Vinset85/smartofono/hardware/anteprime/01-vetro-frontale.png

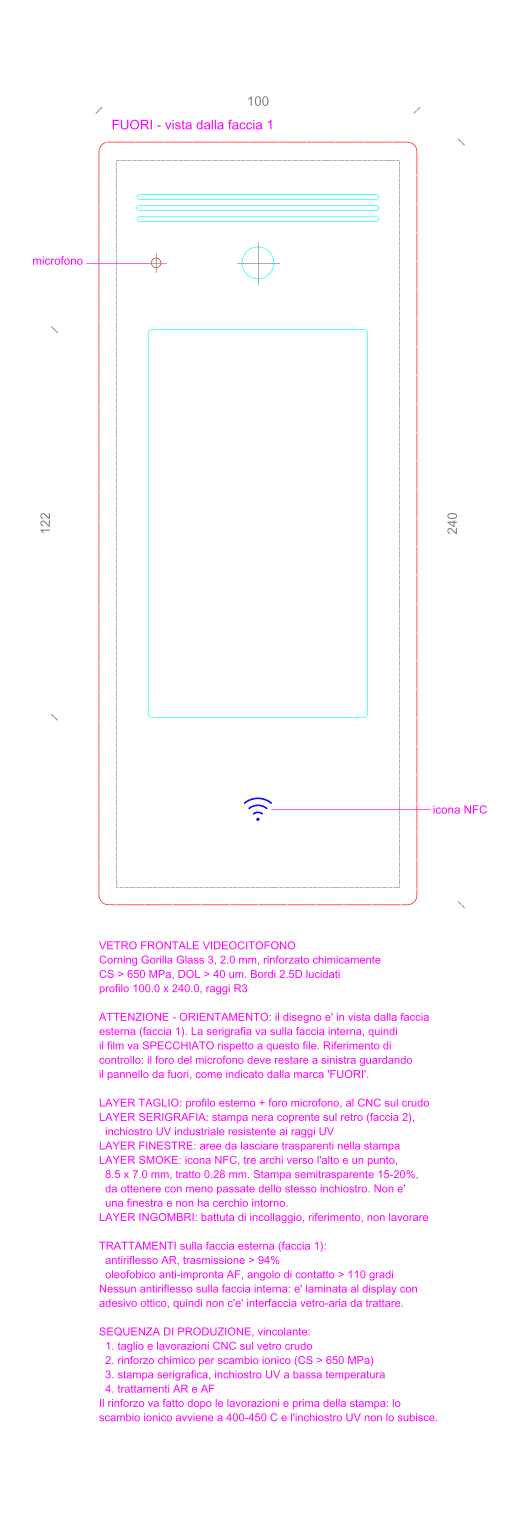
hardware/anteprime/01-vetro-frontale.png
