Vinset85/smartofono/hardware/anteprime/02-telaio-portante.png

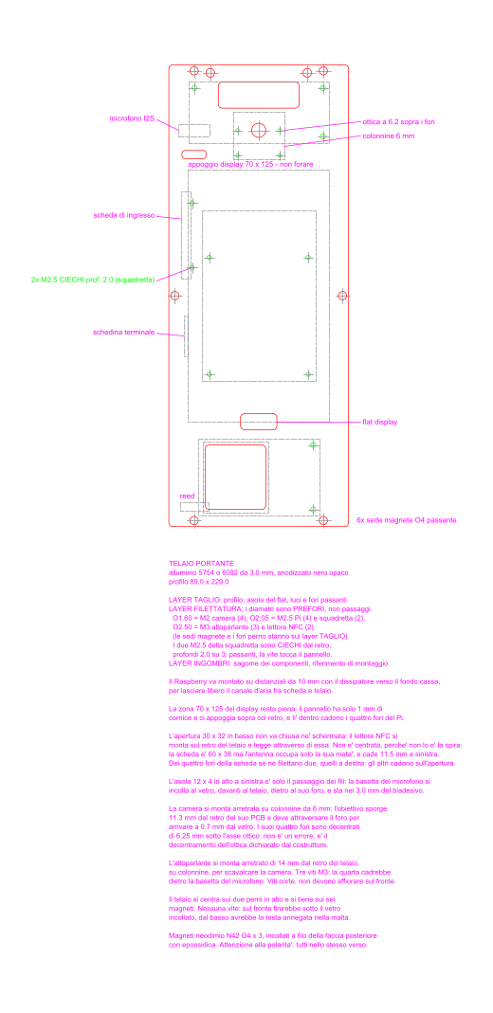
hardware/anteprime/02-telaio-portante.png
