Vinset85/smartofono/hardware/anteprime/03-cassa-incasso.png

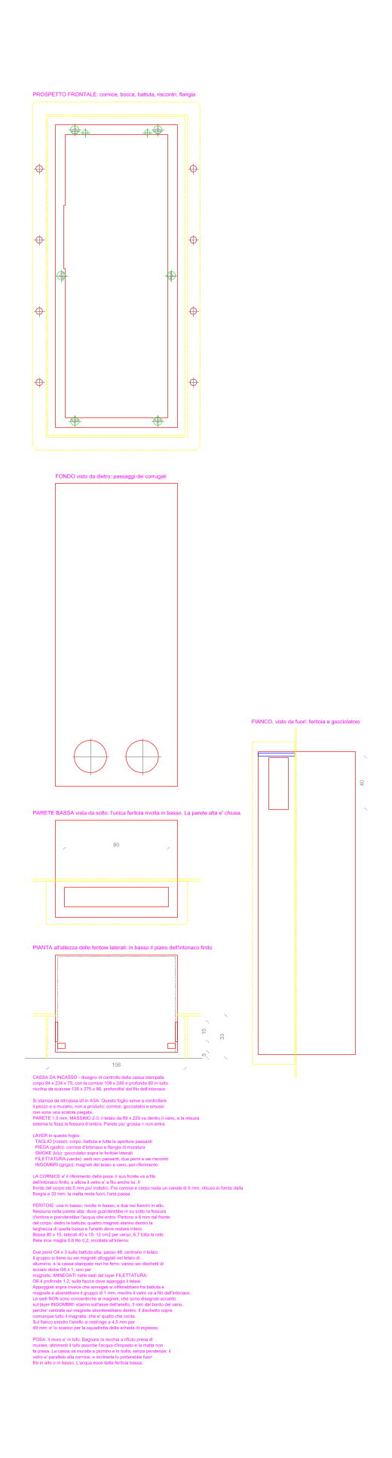
hardware/anteprime/03-cassa-incasso.png
