Vinset85/smartofono/hardware/anteprime/3d-assieme.png

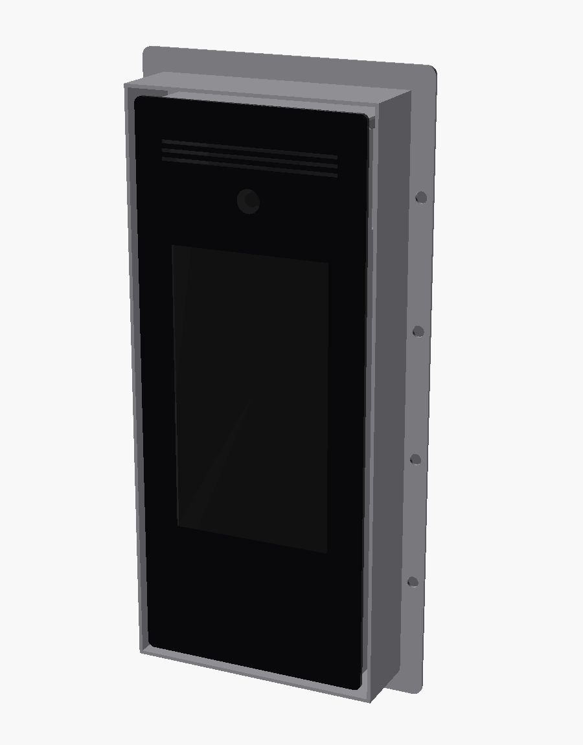
hardware/anteprime/3d-assieme.png
