Vinset85/smartofono/hardware/anteprime/3d-esploso.png

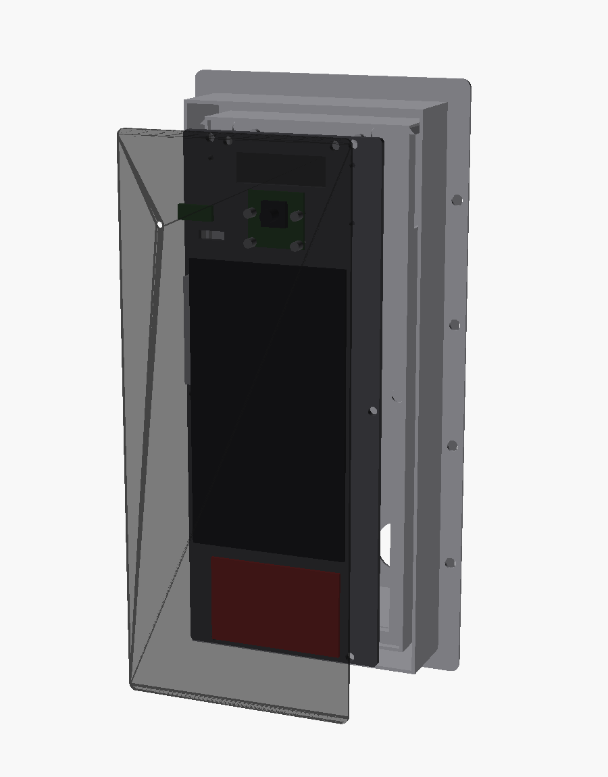
hardware/anteprime/3d-esploso.png
