Vinset85/smartofono/hardware/anteprime/3d-fronte.png

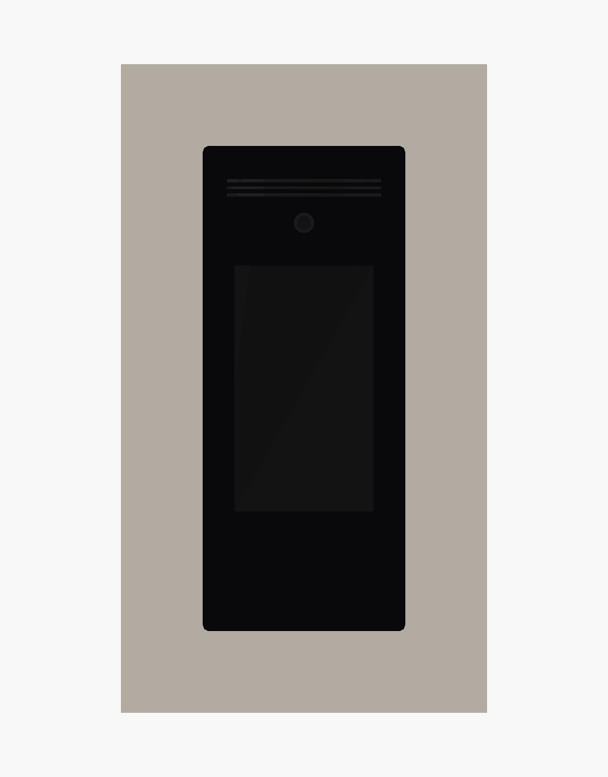
hardware/anteprime/3d-fronte.png
