Vinset85/smartofono/hardware/anteprime/3d-retro.png

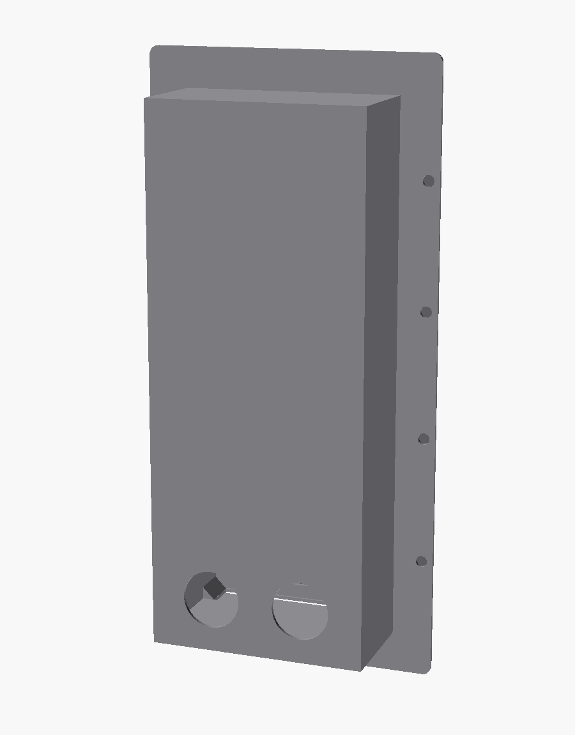
hardware/anteprime/3d-retro.png
