Vinset85/smartofono/hardware/anteprime/3d-sezione.png

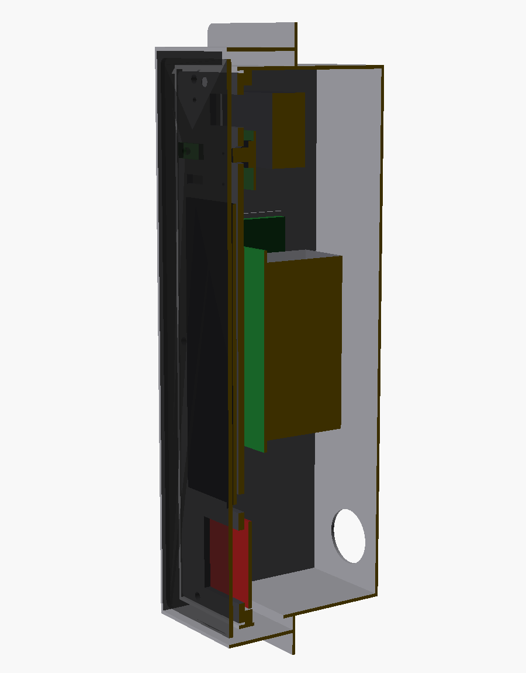
hardware/anteprime/3d-sezione.png
