Vinset85/smartofono/hardware/anteprime/04-dima-muratura.png

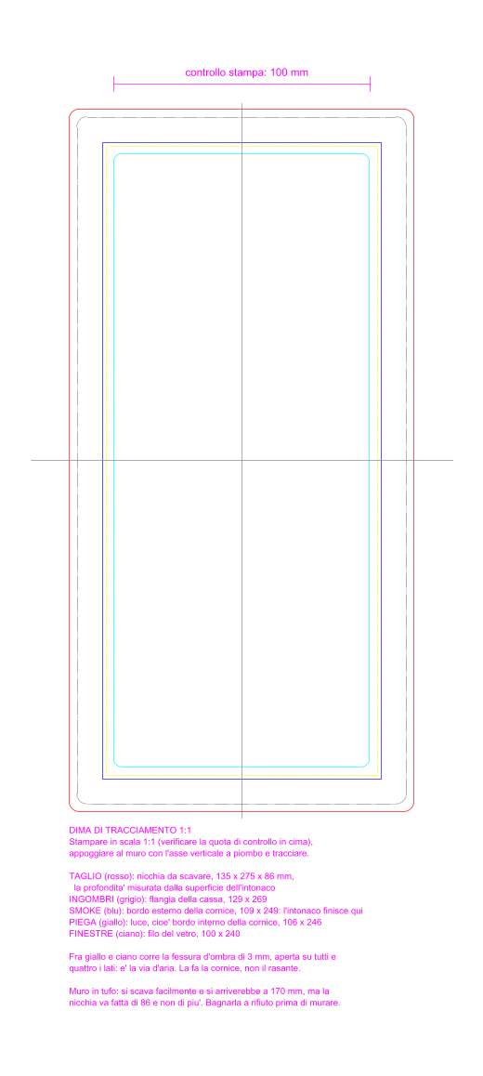
hardware/anteprime/04-dima-muratura.png
