Vinset85/smartofono/hardware/anteprime/05-disposizione.png

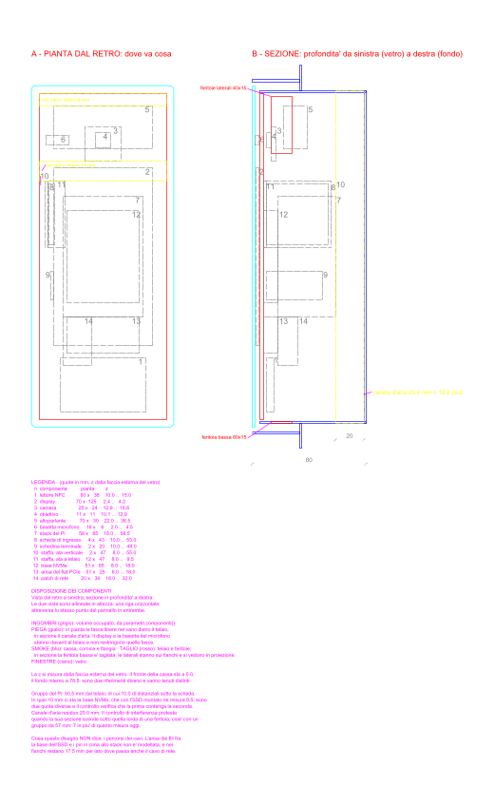
hardware/anteprime/05-disposizione.png
