Vinset85/smartofono/hardware/anteprime/06-gruppo-display.png

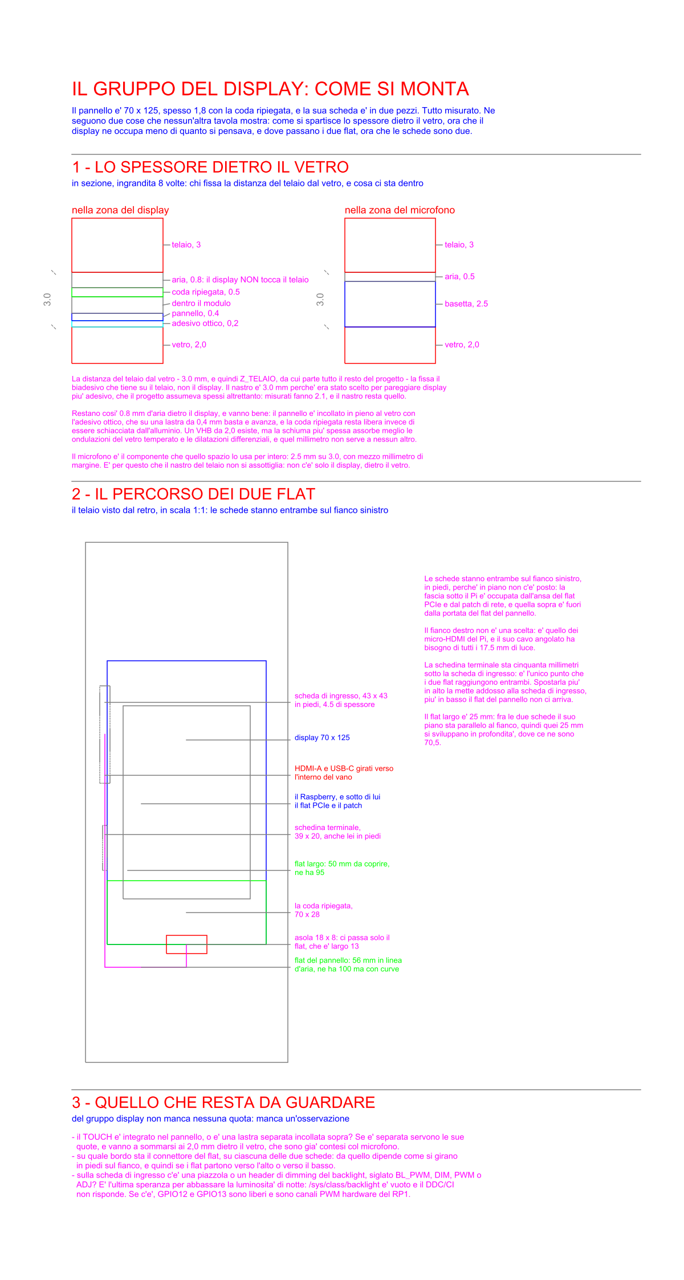
hardware/anteprime/06-gruppo-display.png
