Vinset85/smartofono/hardware/anteprime/07-staffa-e-pezzi-piani.png

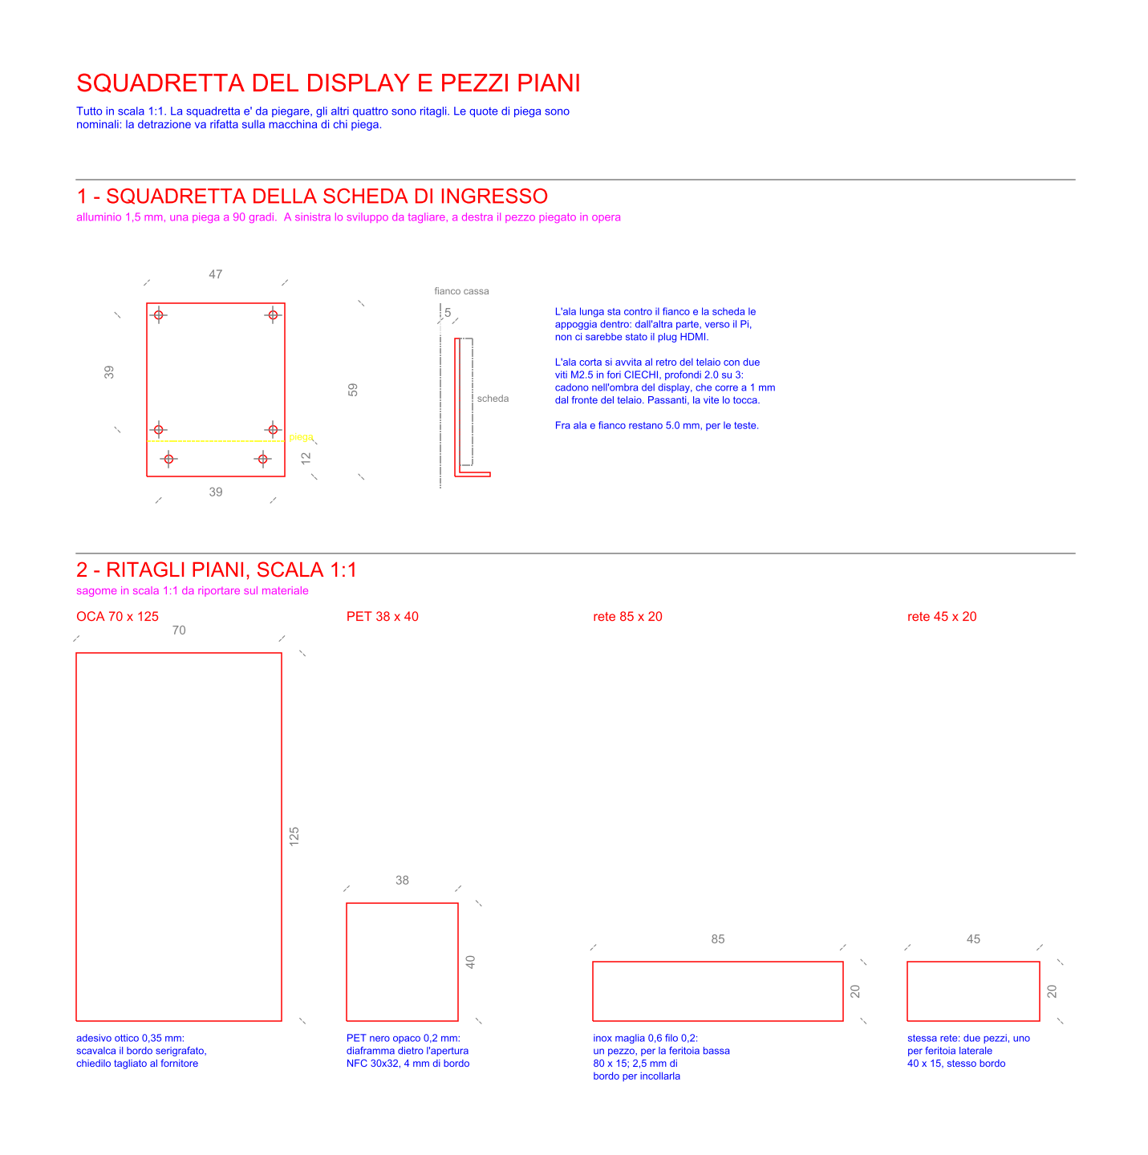
hardware/anteprime/07-staffa-e-pezzi-piani.png
