Vinset85/smartofono/hardware/render/inst-1-nicchia.jpg

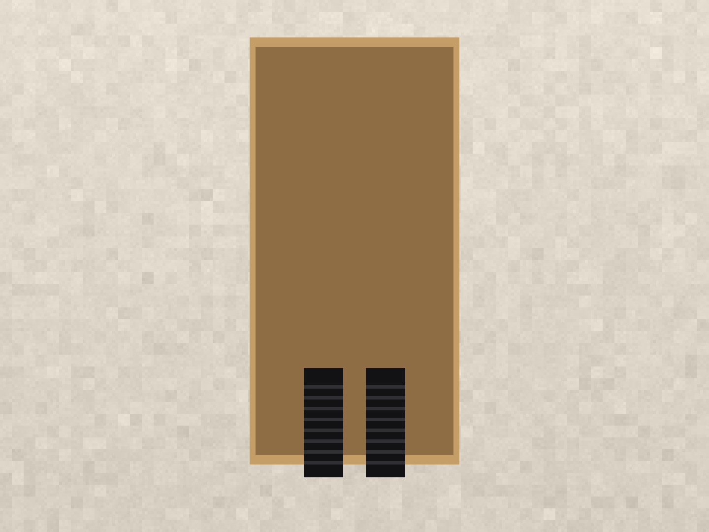
hardware/render/inst-1-nicchia.jpg
