Vinset85/smartofono/hardware/render/inst-2-cassa.jpg

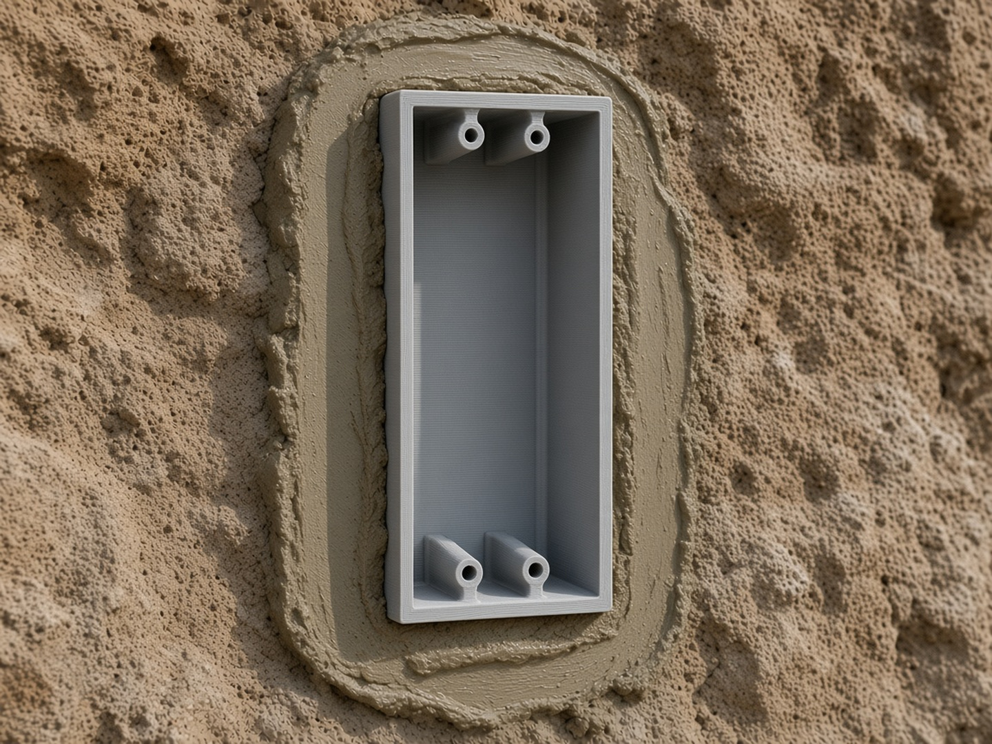
hardware/render/inst-2-cassa.jpg
