Vinset85/smartofono/hardware/render/inst-3-telaio.jpg

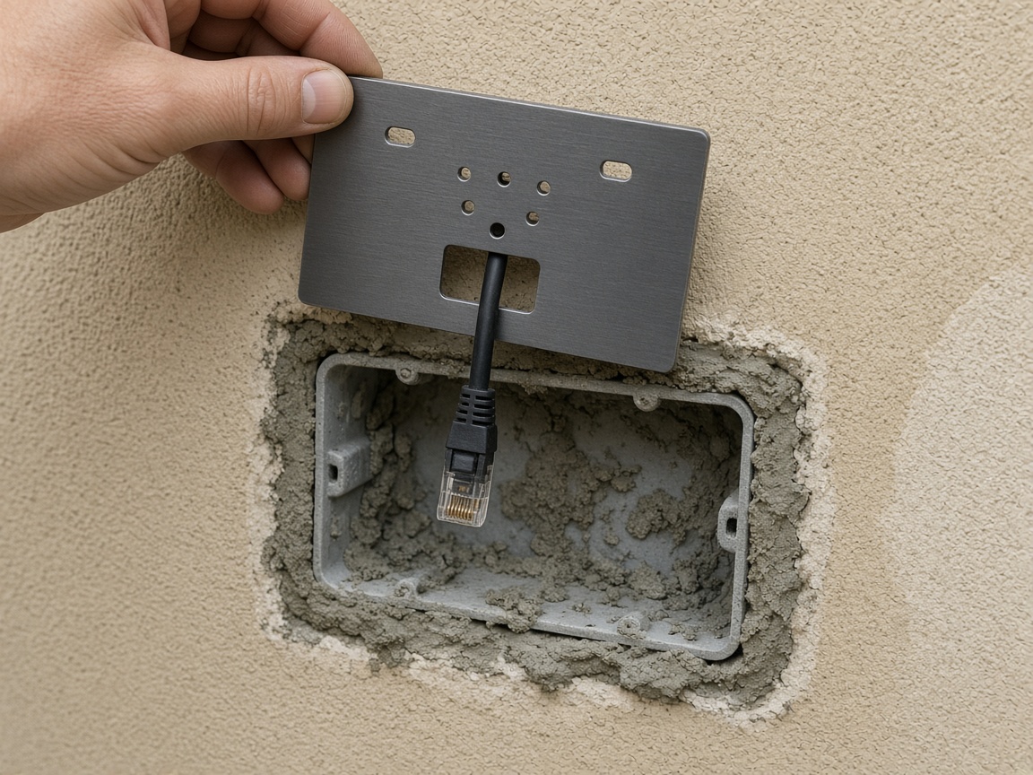
hardware/render/inst-3-telaio.jpg
