Vinset85/smartofono/hardware/render/inst-4-vetro.jpg

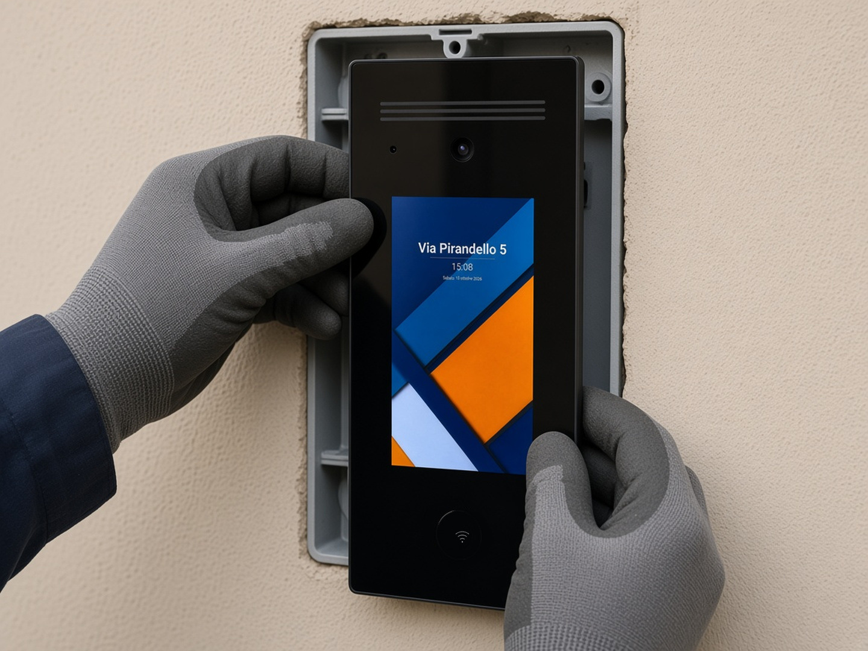
hardware/render/inst-4-vetro.jpg
