Vinset85/smartofono/hardware/render/materiali/alluminio-anodizzato.jpg

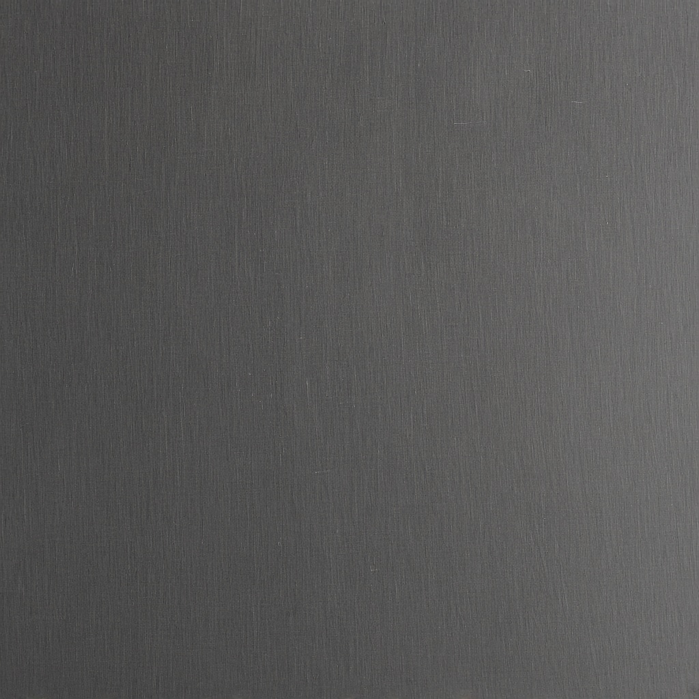
hardware/render/materiali/alluminio-anodizzato.jpg
