Vinset85/smartofono/hardware/render/materiali/angolo-muro.jpg

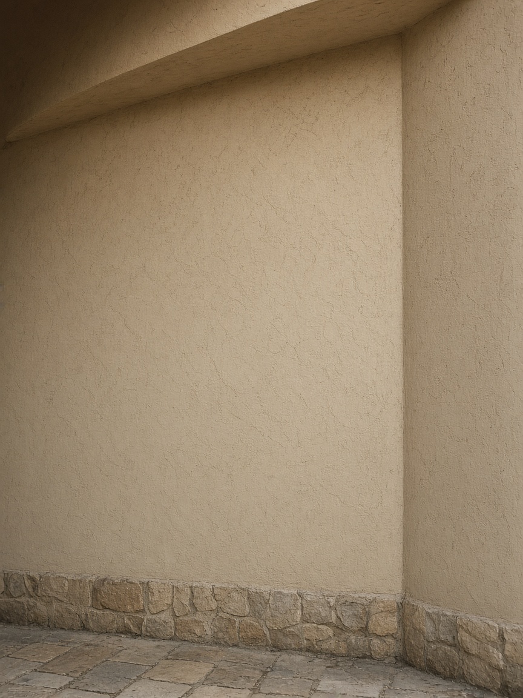
hardware/render/materiali/angolo-muro.jpg
