Vinset85/smartofono/hardware/render/materiali/asa-stampato.jpg

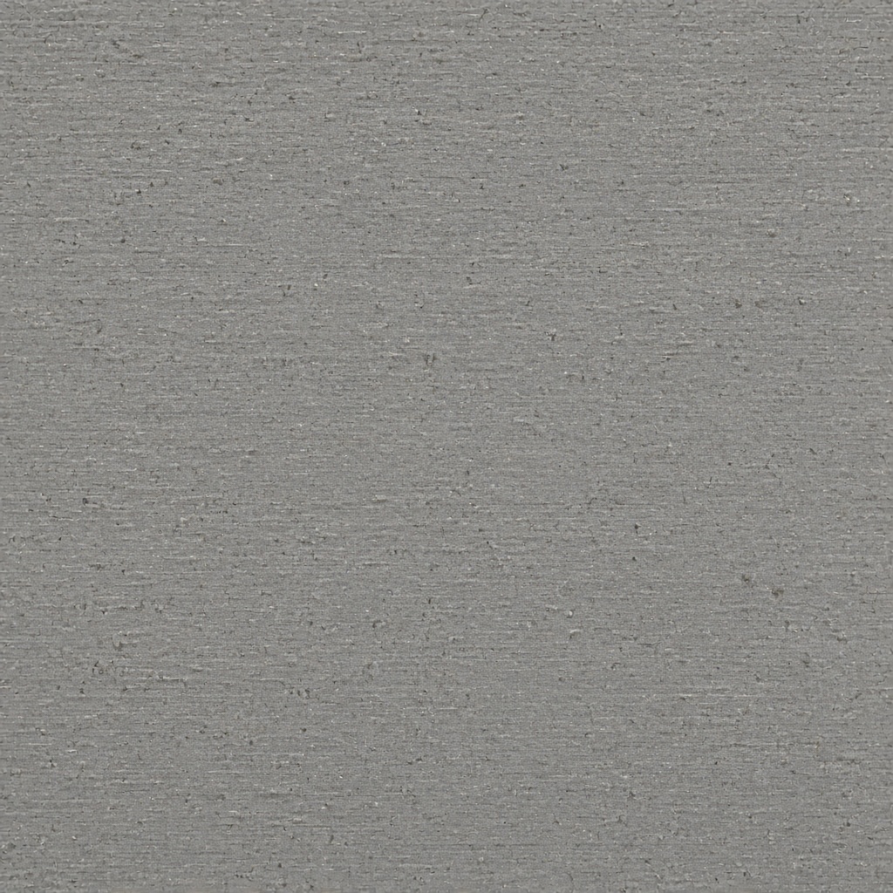
hardware/render/materiali/asa-stampato.jpg
