Vinset85/smartofono/hardware/render/materiali/dito-nero.jpg

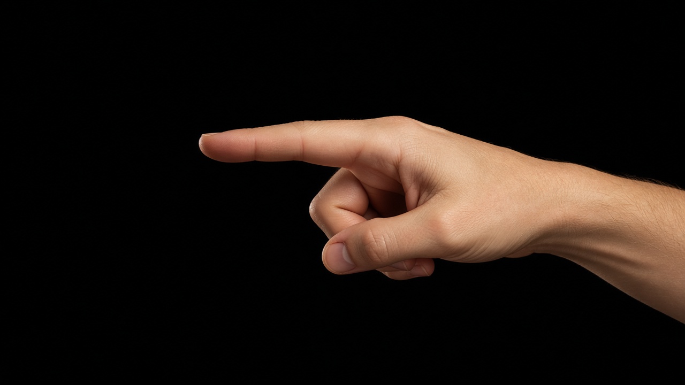
hardware/render/materiali/dito-nero.jpg
