Vinset85/smartofono/hardware/render/materiali/dito-vetro.jpg

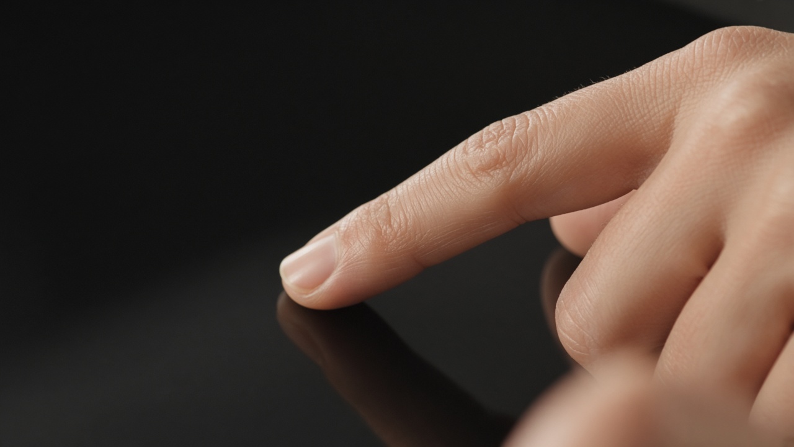
hardware/render/materiali/dito-vetro.jpg
