Vinset85/smartofono/hardware/render/materiali/intonaco-portico.jpg

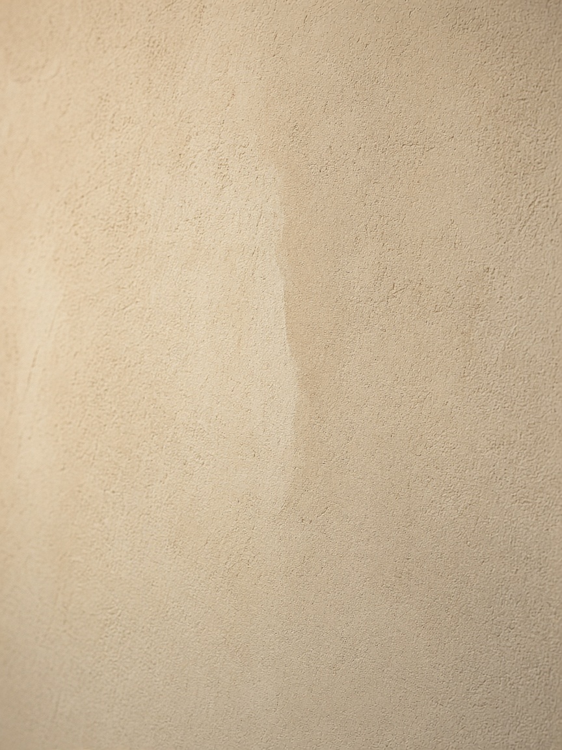
hardware/render/materiali/intonaco-portico.jpg
