Vinset85/smartofono/hardware/render/materiali/malta-fresca.jpg

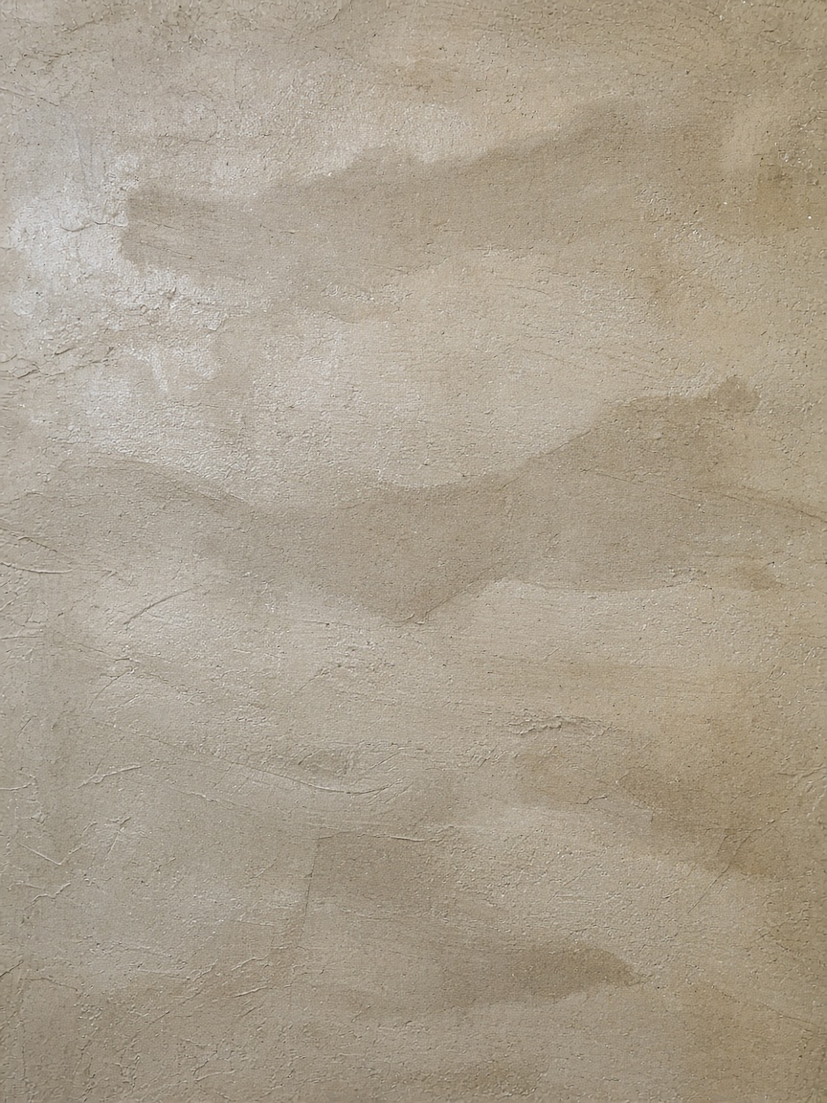
hardware/render/materiali/malta-fresca.jpg
