Vinset85/smartofono/hardware/render/materiali/oled-chiamata.jpg

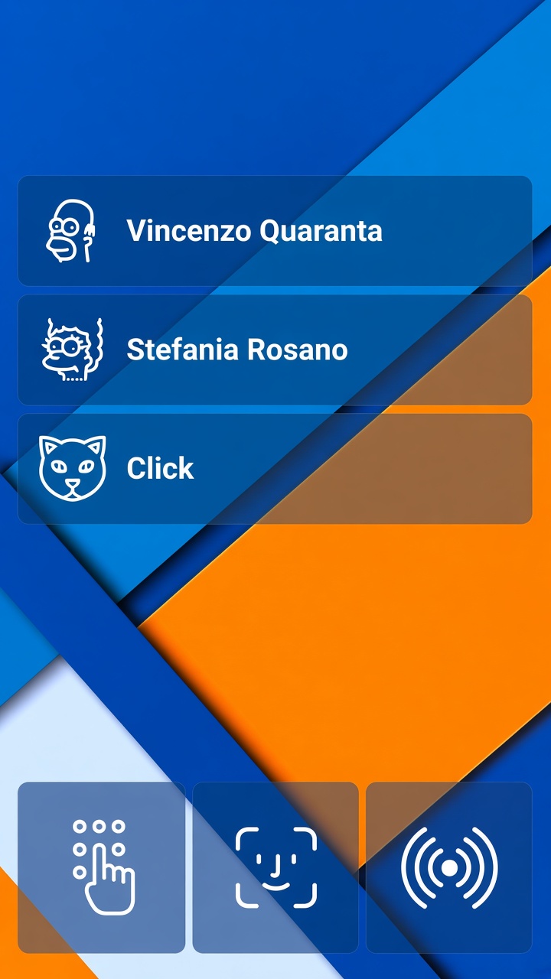
hardware/render/materiali/oled-chiamata.jpg
