Vinset85/smartofono/hardware/render/materiali/oled-riposo.jpg

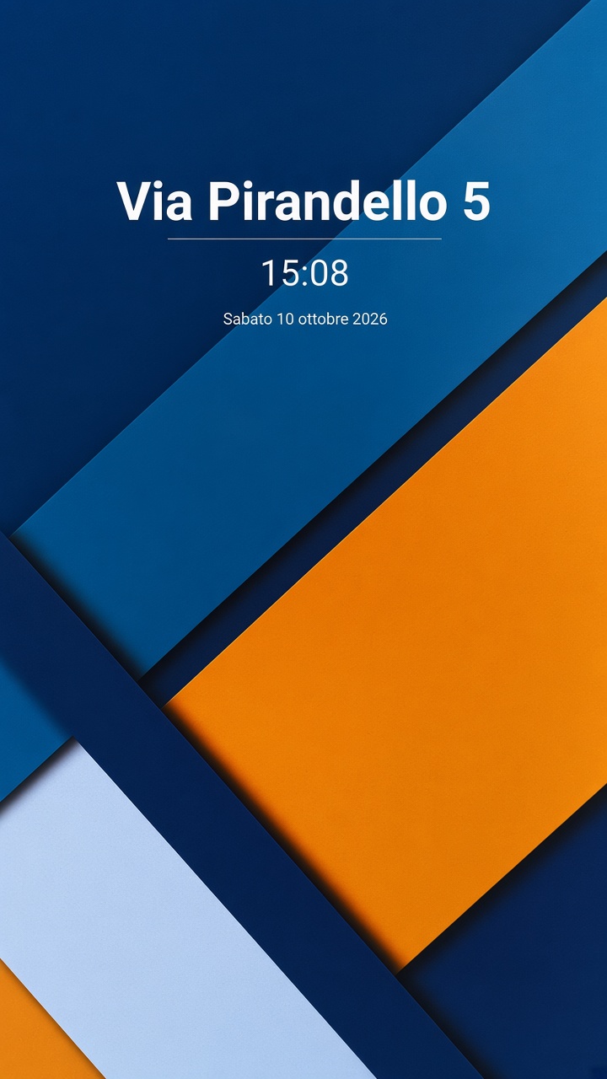
hardware/render/materiali/oled-riposo.jpg
