Vinset85/smartofono/hardware/render/materiali/porta-legno.jpg

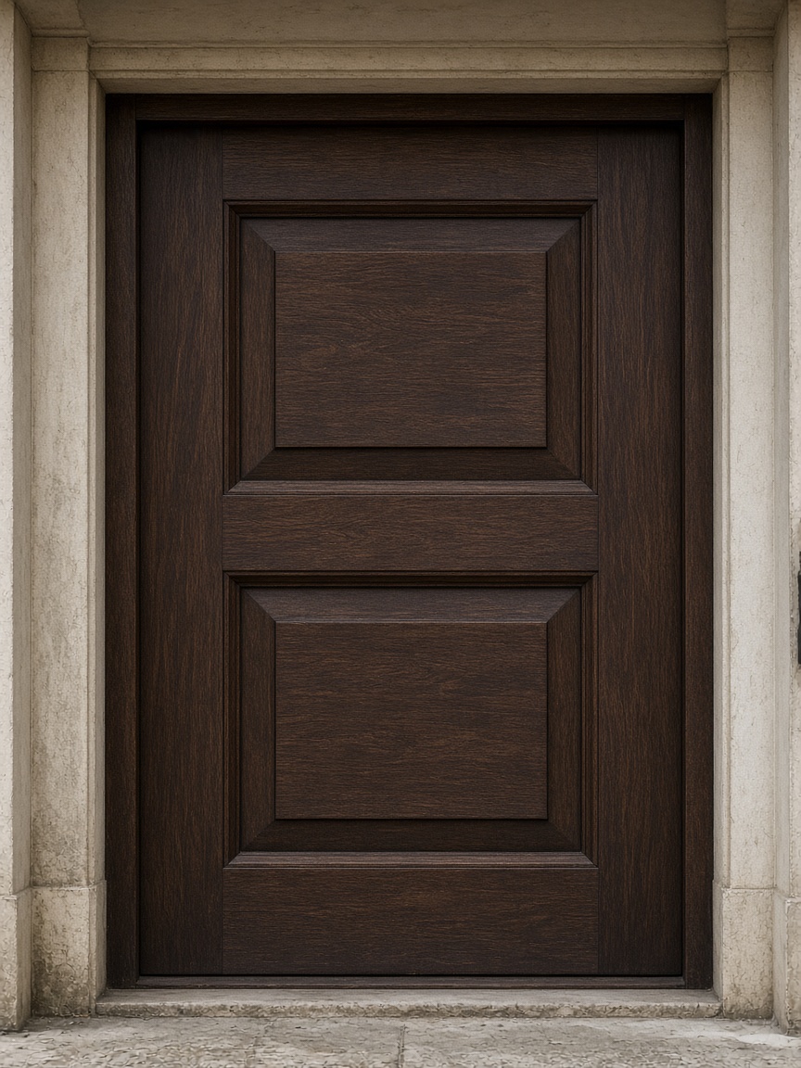
hardware/render/materiali/porta-legno.jpg
