Vinset85/smartofono/hardware/render/materiali/riflesso-portico.jpg

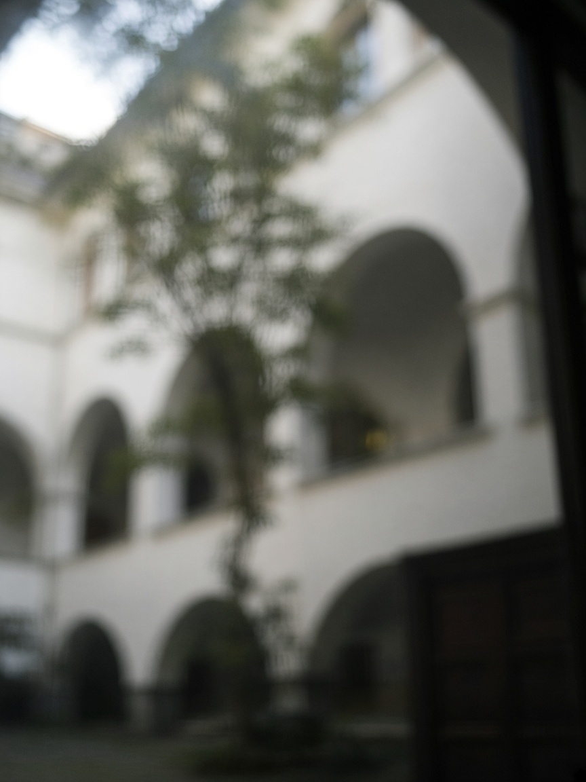
hardware/render/materiali/riflesso-portico.jpg
