Vinset85/smartofono/hardware/render/materiali/tufo-taglio.jpg

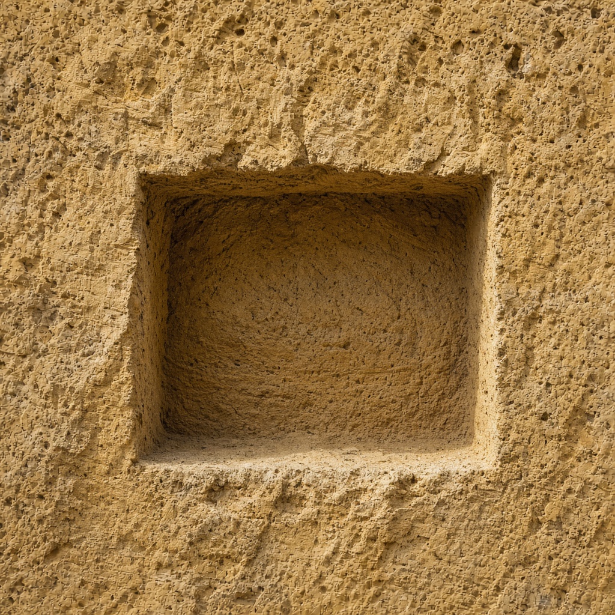
hardware/render/materiali/tufo-taglio.jpg
