Vinset85/smartofono/hardware/render/materiali/volto-nero.jpg

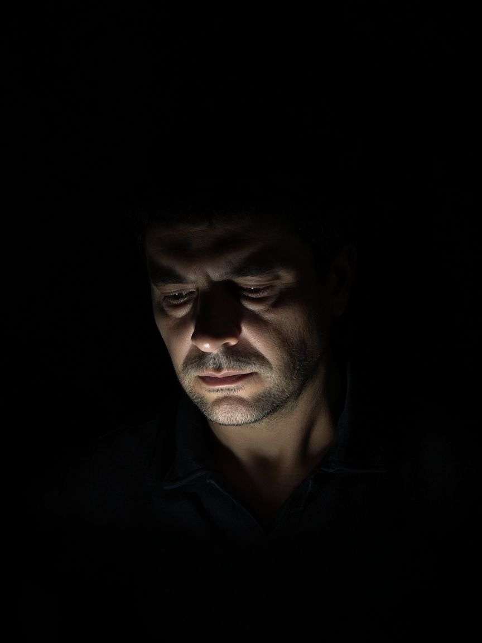
hardware/render/materiali/volto-nero.jpg
