Vinset85/smartofono/hardware/render/materiali/volto-sotto.jpg

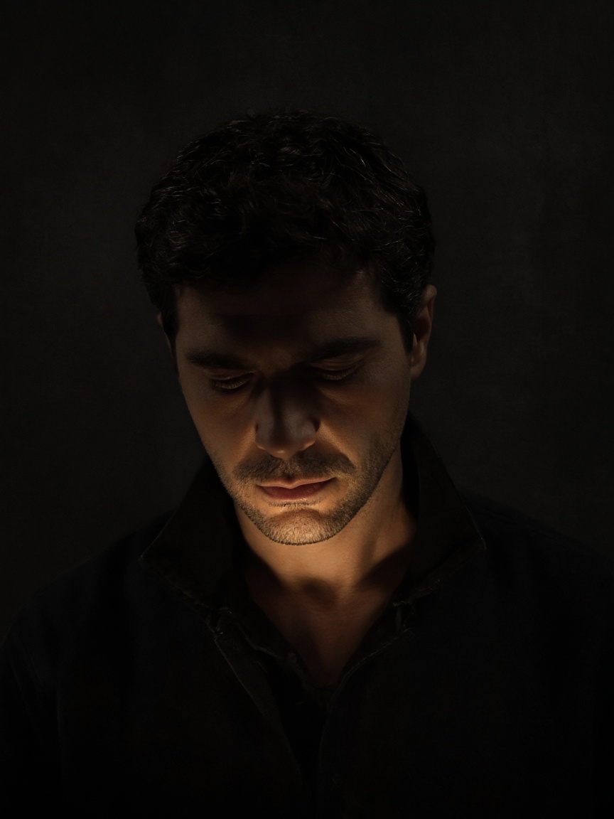
hardware/render/materiali/volto-sotto.jpg
