Vinset85/smartofono/hardware/render/scala/fronte-a-muro.jpg

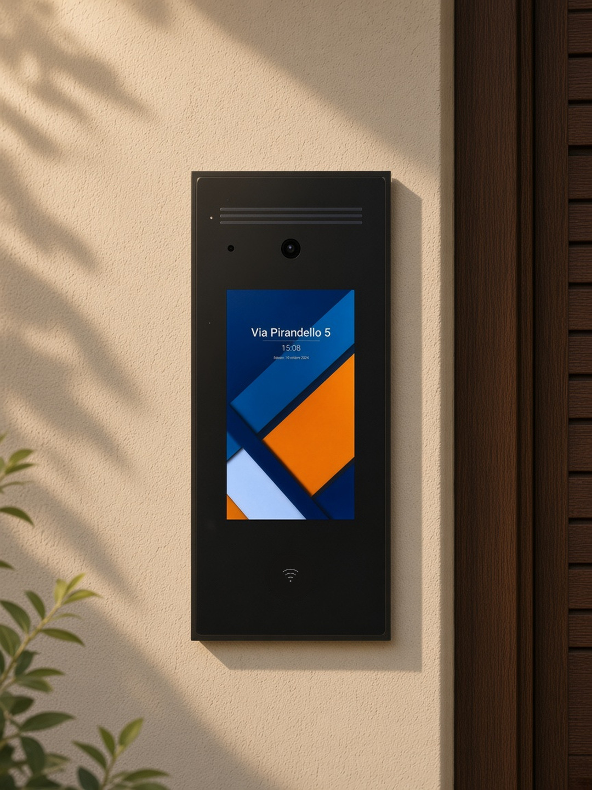
hardware/render/scala/fronte-a-muro.jpg
