Vinset85/smartofono/hardware/render/scala/func-1-giorno-riposo.jpg

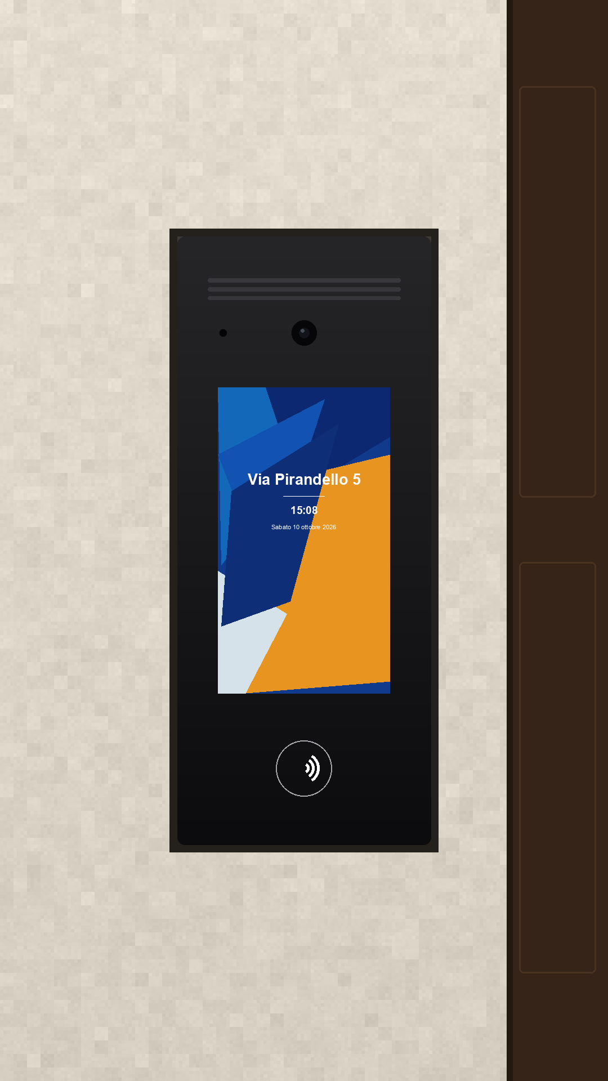
hardware/render/scala/func-1-giorno-riposo.jpg
