Vinset85/smartofono/hardware/render/scala/func-3-notte-piena.jpg

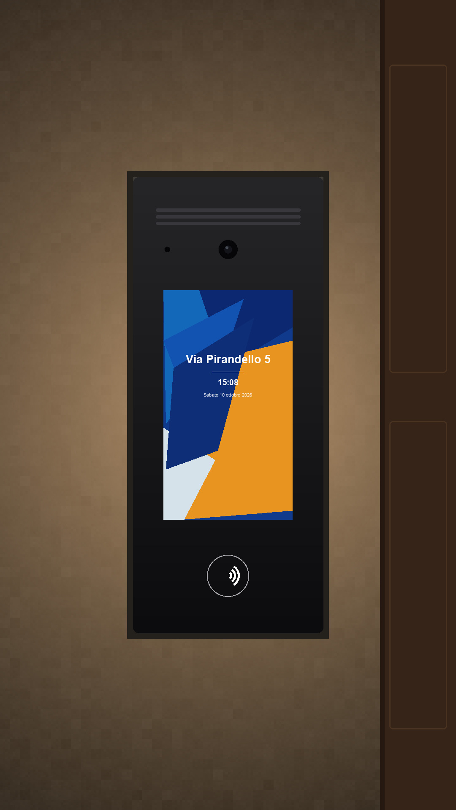
hardware/render/scala/func-3-notte-piena.jpg
