Vinset85/smartofono/hardware/render/scala/inst-2-cassa.jpg

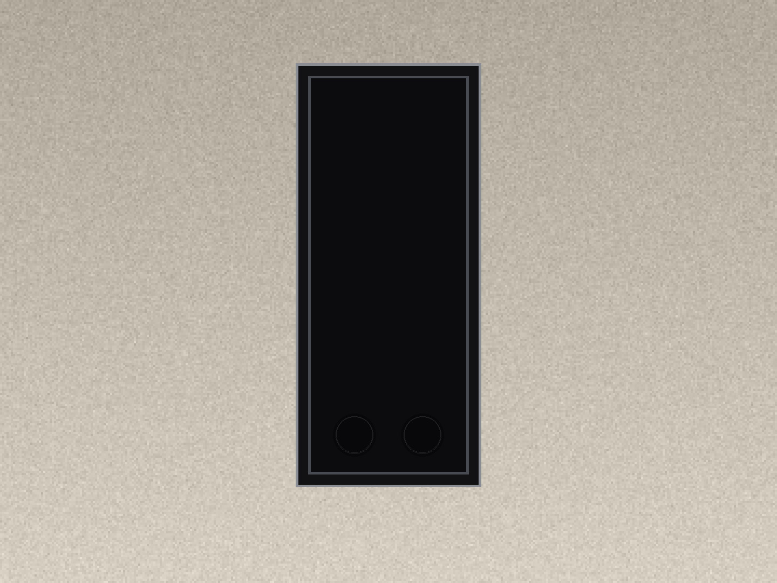
hardware/render/scala/inst-2-cassa.jpg
