Vinset85/smartofono/hardware/render/scala/inst-3-telaio.jpg

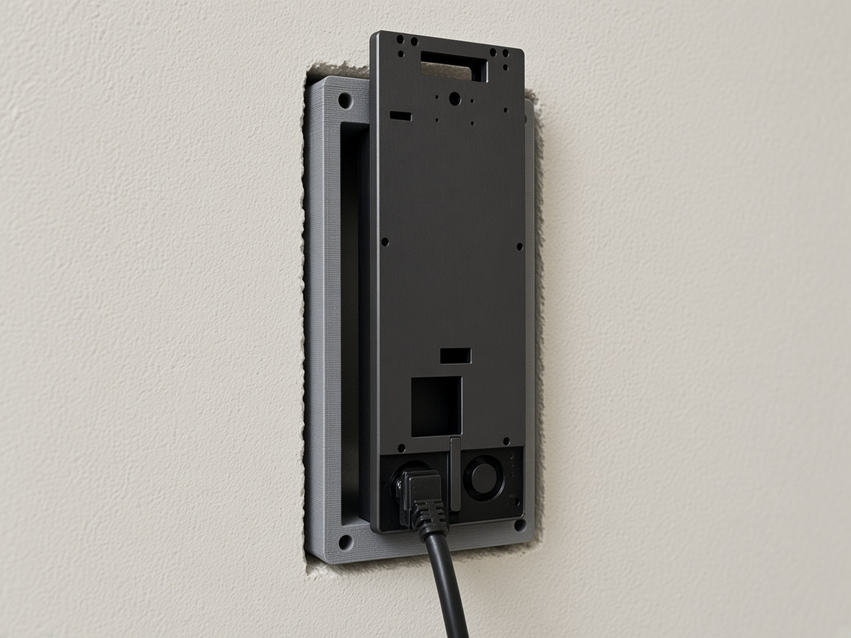
hardware/render/scala/inst-3-telaio.jpg
