Vinset85/smartofono/hardware/render/scala/inst-4-vetro.jpg

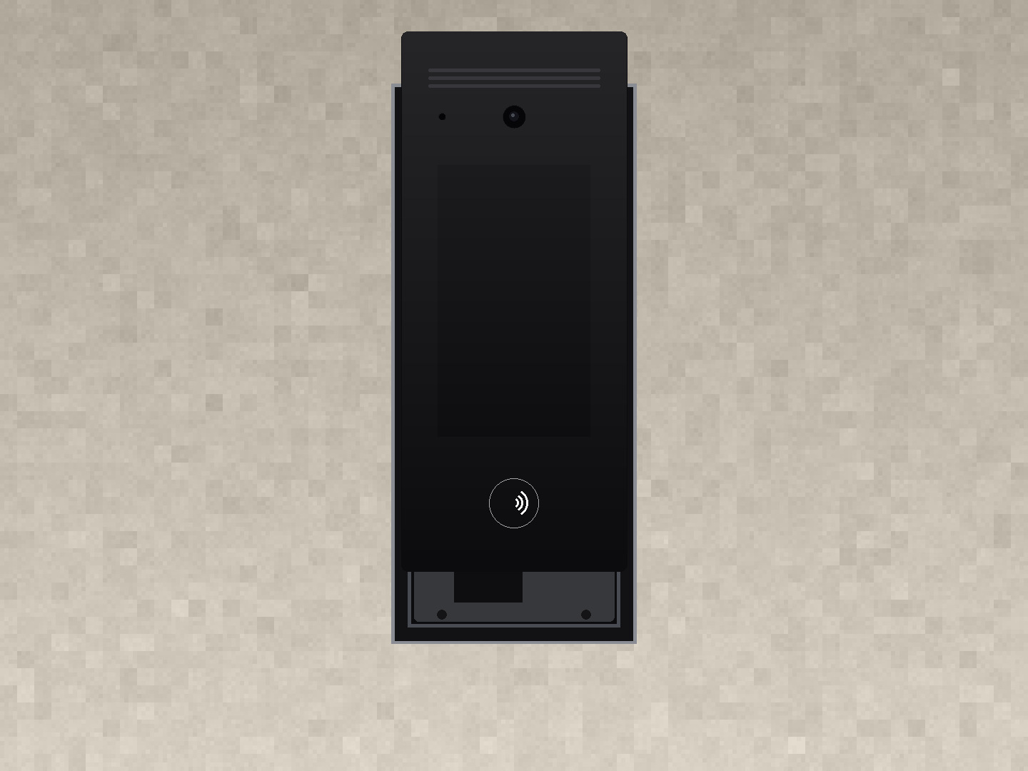
hardware/render/scala/inst-4-vetro.jpg
