Vinset85/smartofono/hardware/render/schermata-default.jpg

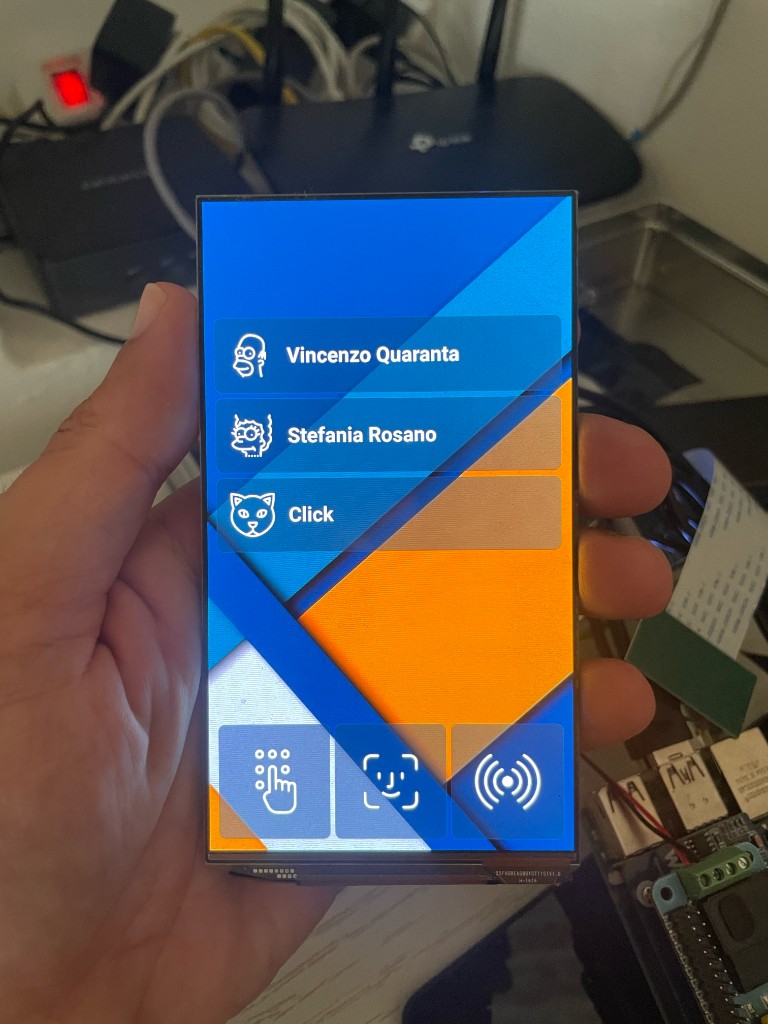
hardware/render/schermata-default.jpg
