Vinset85/smartofono/hardware/render/schermata-riposo.jpg

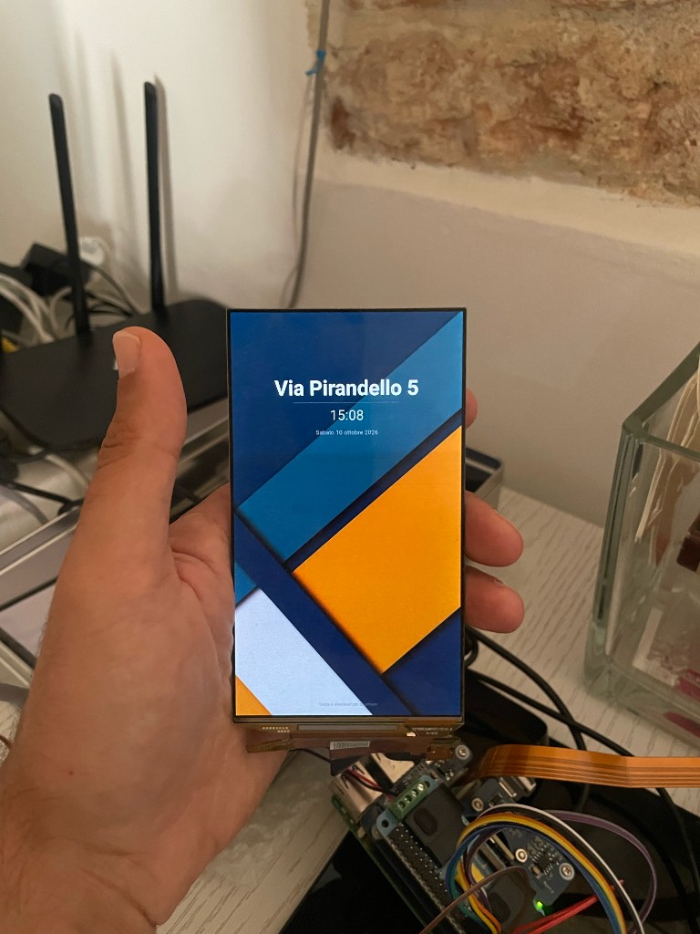
hardware/render/schermata-riposo.jpg
