Vinset85/smartofono/hardware/cad/05-disposizione.dxf

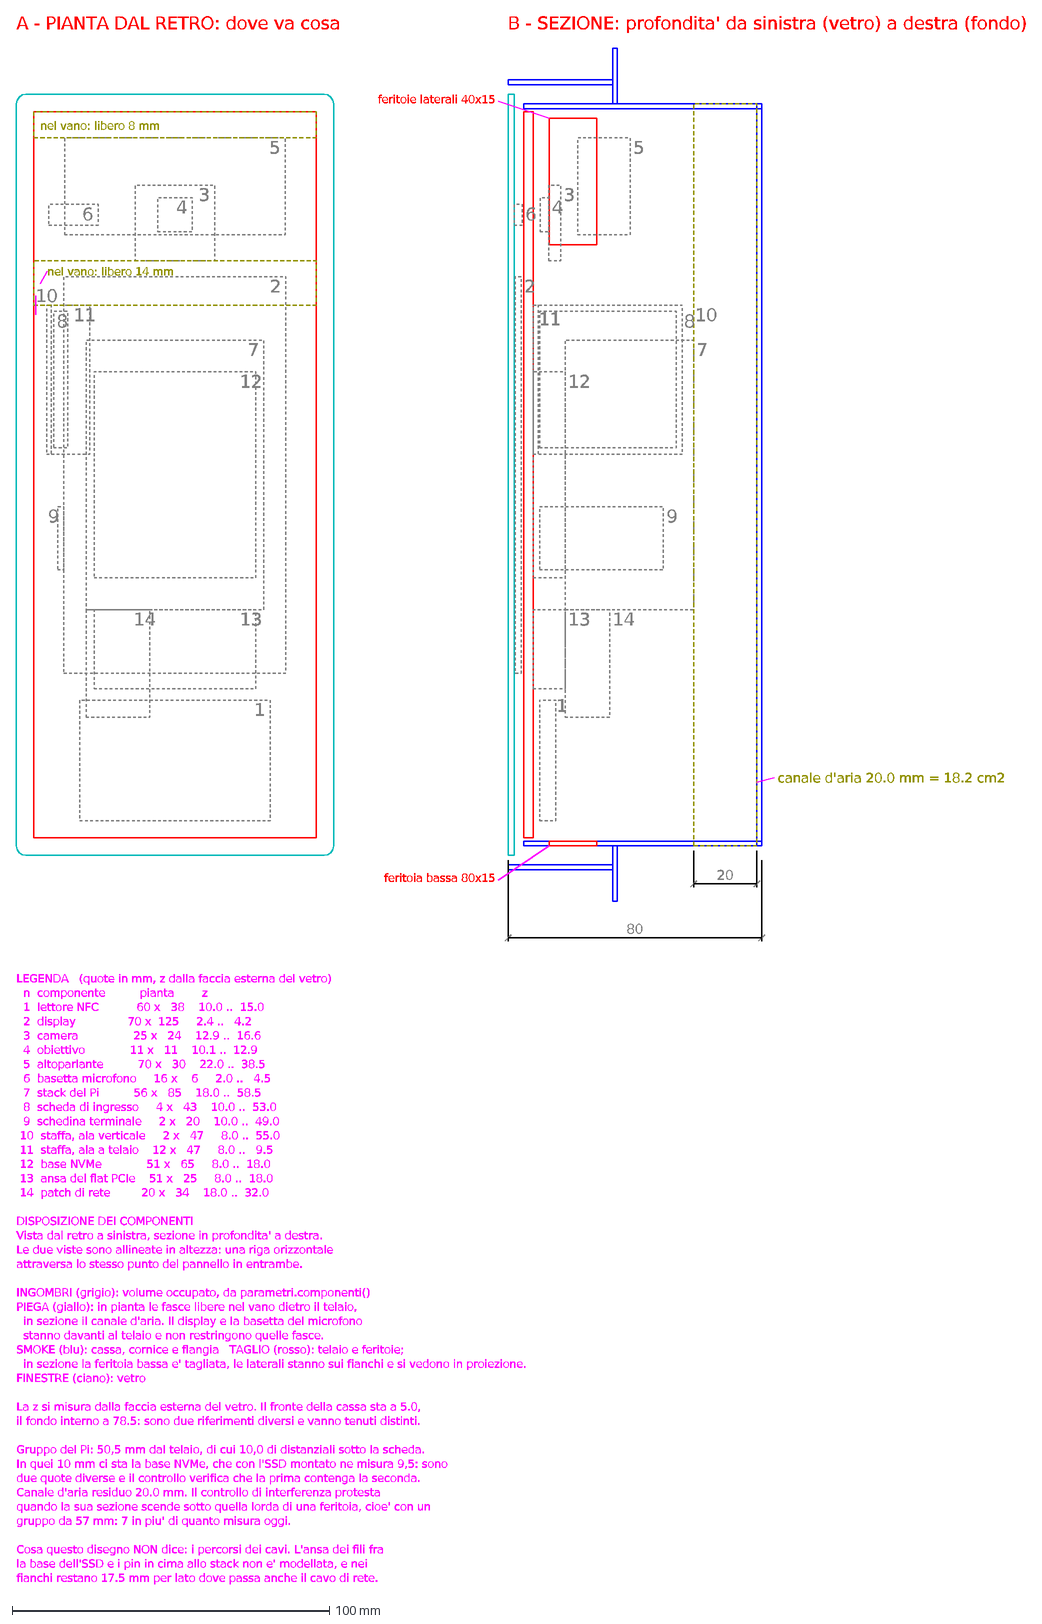
[picture p49: CAD file, 2026-10-16]
hardware/cad/05-disposizione.dxf
A - PIANTA DAL RETRO: dove va cosa
nel vano: libero 14 mm
nel vano: libero 8 mm
1
2
3
4
5
6
7
8
9
10
11
12
13
14
B - SEZIONE: profondita' da sinistra (vetro) a destra (fondo)
20
80
feritoia bassa 80x15
feritoie laterali 40x15
canale d'aria 20.0 mm = 18.2 cm2
LEGENDA (quote in mm, z dalla faccia esterna del vetro)
n componente pianta z
1 lettore NFC 60 x 38 10.0 .. 15.0
2 display 70 x 125 2.4 .. 4.2
3 camera 25 x 24 12.9 .. 16.6
4 obiettivo 11 x 11 10.1 .. 12.9
5 altoparlante 70 x 30 22.0 .. 38.5
6 basetta microfono 16 x 6 2.0 .. 4.5
7 stack del Pi 56 x 85 18.0 .. 58.5
8 scheda di ingresso 4 x 43 10.0 .. 53.0
9 schedina terminale 2 x 20 10.0 .. 49.0
10 staffa, ala verticale 2 x 47 8.0 .. 55.0
11 staffa, ala a telaio 12 x 47 8.0 .. 9.5
12 base NVMe 51 x 65 8.0 .. 18.0
13 ansa del flat PCIe 51 x 25 8.0 .. 18.0
14 patch di rete 20 x 34 18.0 .. 32.0
DISPOSIZIONE DEI COMPONENTI
Vista dal retro a sinistra, sezione in profondita' a destra.
Le due viste sono allineate in altezza: una riga orizzontale
attraversa lo stesso punto del pannello in entrambe.
INGOMBRI (grigio): volume occupato, da parametri.componenti()
PIEGA (giallo): in pianta le fasce libere nel vano dietro il telaio,
in sezione il canale d'aria. Il display e la basetta del microfono
stanno davanti al telaio e non restringono quelle fasce.
SMOKE (blu): cassa, cornice e flangia TAGLIO (rosso): telaio e feritoie;
in sezione la feritoia bassa e' tagliata, le laterali stanno sui fianchi e si vedono in proiezione.
FINESTRE (ciano): vetro
La z si misura dalla faccia esterna del vetro. Il fronte della cassa sta a 5.0,
il fondo interno a 78.5: sono due riferimenti diversi e vanno tenuti distinti.
Gruppo del Pi: 50,5 mm dal telaio, di cui 10,0 di distanziali sotto la scheda.
In quei 10 mm ci sta la base NVMe, che con l'SSD montato ne misura 9,5: sono
due quote diverse e il controllo verifica che la prima contenga la seconda.
Canale d'aria residuo 20.0 mm. Il controllo di interferenza protesta
quando la sua sezione scende sotto quella lorda di una feritoia, cioe' con un
gruppo da 57 mm: 7 in piu' di quanto misura oggi.
Cosa questo disegno NON dice: i percorsi dei cavi. L'ansa dei fili fra
la base dell'SSD e i pin in cima allo stack non e' modellata, e nei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
