Vinset85/smartofono/hardware/stl/cassa.stl

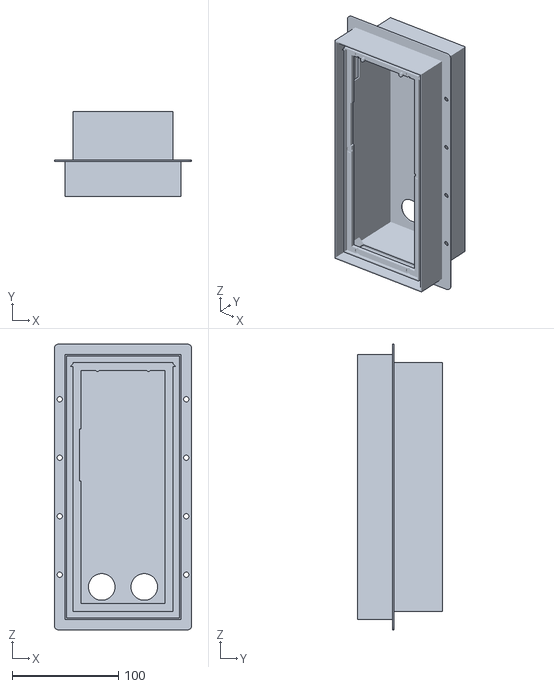
[picture p50: CAD file, 2026-10-11]
hardware/stl/cassa.stl
129.0 x 80.0 x 269.0
