Vinset85/smartofono/hardware/cad/07-staffa-e-pezzi-piani.dxf

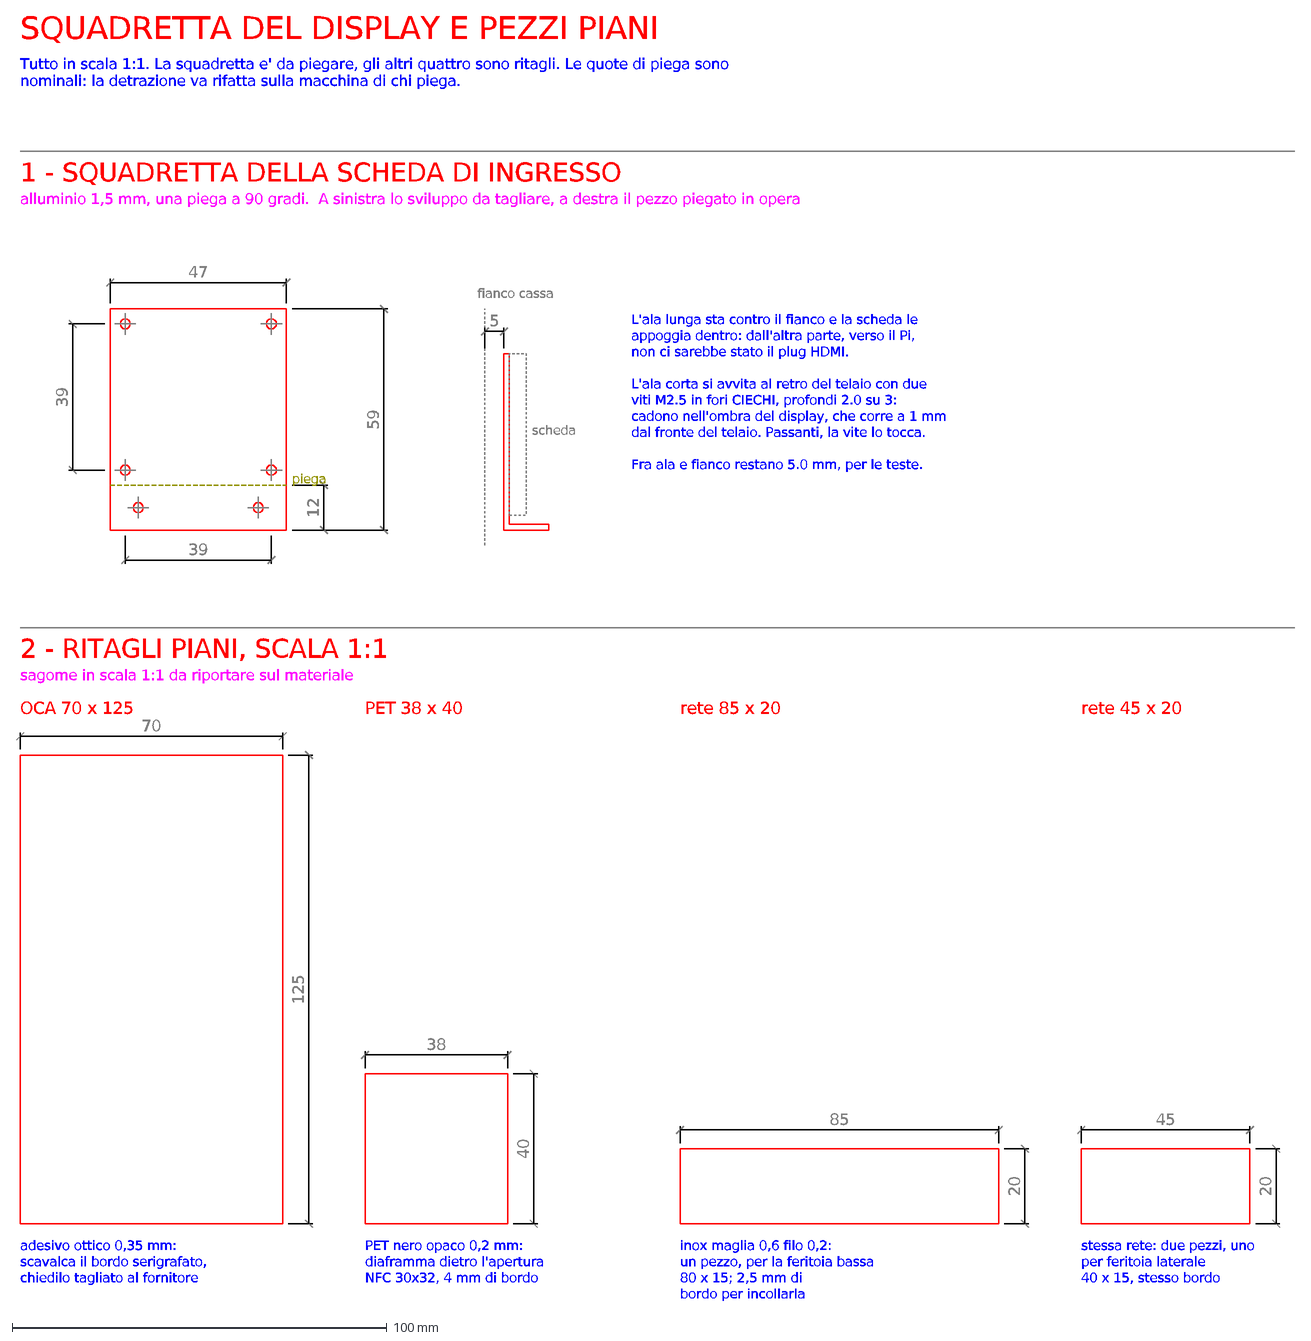
[picture p51: CAD file, 2026-10-16]
hardware/cad/07-staffa-e-pezzi-piani.dxf
SQUADRETTA DEL DISPLAY E PEZZI PIANI
Tutto in scala 1:1. La squadretta e' da piegare, gli altri quattro sono ritagli. Le quote di piega sono
nominali: la detrazione va rifatta sulla macchina di chi piega.
1 - SQUADRETTA DELLA SCHEDA DI INGRESSO
alluminio 1,5 mm, una piega a 90 gradi. A sinistra lo sviluppo da tagliare, a destra il pezzo piegato in opera
47
39
59
12
piega
scheda
fianco cassa
5
L'ala lunga sta contro il fianco e la scheda le
appoggia dentro: dall'altra parte, verso il Pi,
non ci sarebbe stato il plug HDMI.
L'ala corta si avvita al retro del telaio con due
viti M2.5 in fori CIECHI, profondi 2.0 su 3:
cadono nell'ombra del display, che corre a 1 mm
dal fronte del telaio. Passanti, la vite lo tocca.
Fra ala e fianco restano 5.0 mm, per le teste.
2 - RITAGLI PIANI, SCALA 1:1
sagome in scala 1:1 da riportare sul materiale
OCA 70 x 125
70
125
adesivo ottico 0,35 mm:
scavalca il bordo serigrafato,
chiedilo tagliato al fornitore
PET 38 x 40
38
40
PET nero opaco 0,2 mm:
diaframma dietro l'apertura
NFC 30x32, 4 mm di bordo
rete 85 x 20
85
20
inox maglia 0,6 filo 0,2:
un pezzo, per la feritoia bassa
80 x 15; 2,5 mm di
bordo per incollarla
rete 45 x 20
45
stessa rete: due pezzi, uno
per feritoia laterale
40 x 15, stesso bordo
