Vinset85/smartofono/hardware/stl/vetro.stl

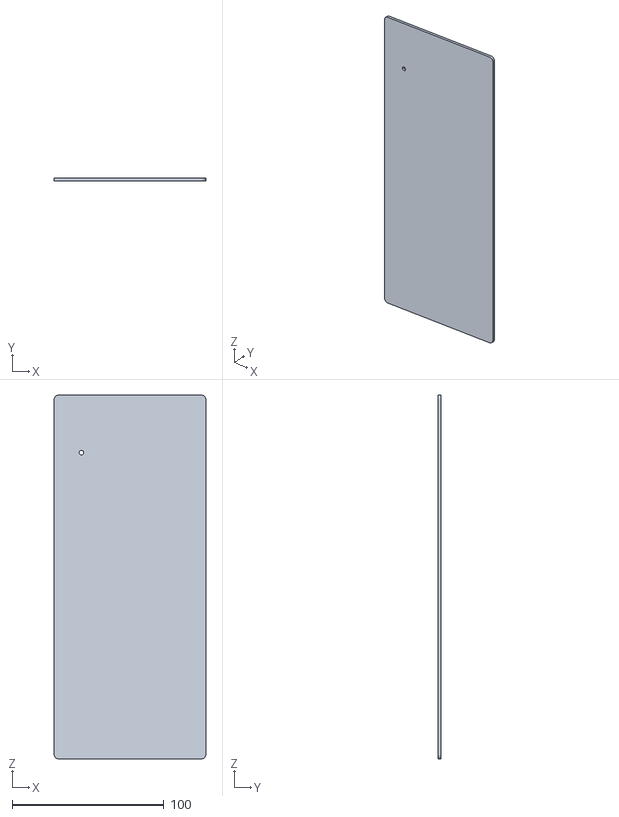
[picture p52: CAD file, 2026-10-10]
hardware/stl/vetro.stl
100.0 x 2.00 x 240.0
