Vinset85/smartofono/hardware/cad/06-gruppo-display.dxf

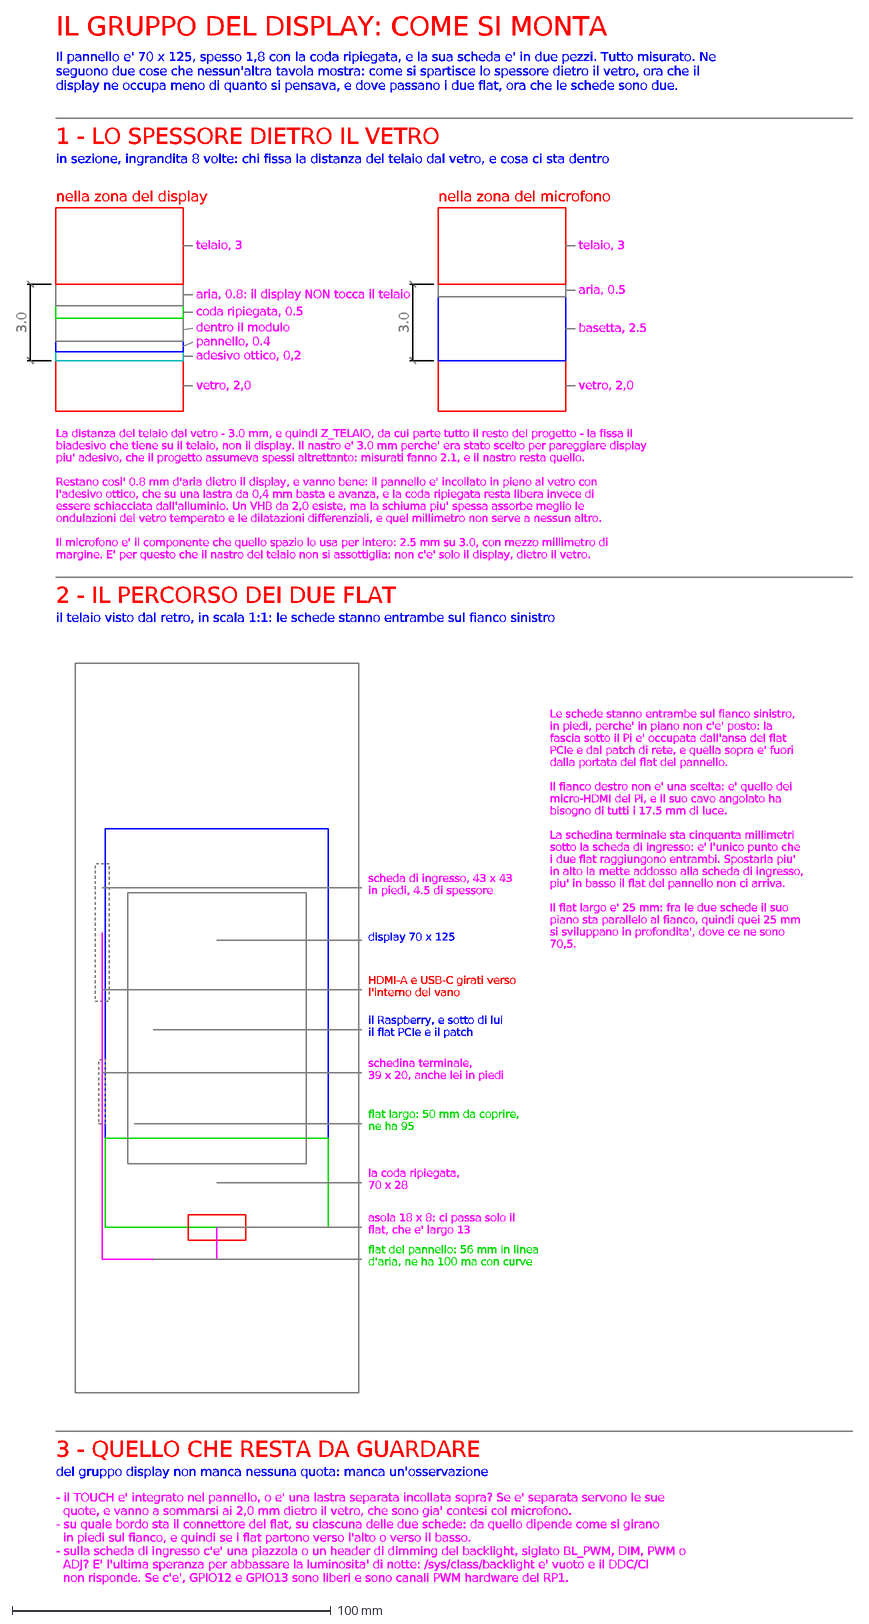
[picture p53: CAD file, 2026-10-16]
hardware/cad/06-gruppo-display.dxf
IL GRUPPO DEL DISPLAY: COME SI MONTA
Il pannello e' 70 x 125, spesso 1,8 con la coda ripiegata, e la sua scheda e' in due pezzi. Tutto misurato. Ne
seguono due cose che nessun'altra tavola mostra: come si spartisce lo spessore dietro il vetro, ora che il
display ne occupa meno di quanto si pensava, e dove passano i due flat, ora che le schede sono due.
1 - LO SPESSORE DIETRO IL VETRO
in sezione, ingrandita 8 volte: chi fissa la distanza del telaio dal vetro, e cosa ci sta dentro
nella zona del display
vetro, 2,0
adesivo ottico, 0,2
pannello, 0.4
dentro il modulo
coda ripiegata, 0.5
aria, 0.8: il display NON tocca il telaio
telaio, 3
3.0
nella zona del microfono
basetta, 2.5
aria, 0.5
La distanza del telaio dal vetro - 3.0 mm, e quindi Z_TELAIO, da cui parte tutto il resto del progetto - la fissa il
biadesivo che tiene su il telaio, non il display. Il nastro e' 3.0 mm perche' era stato scelto per pareggiare display
piu' adesivo, che il progetto assumeva spessi altrettanto: misurati fanno 2.1, e il nastro resta quello.
Restano cosi' 0.8 mm d'aria dietro il display, e vanno bene: il pannello e' incollato in pieno al vetro con
l'adesivo ottico, che su una lastra da 0,4 mm basta e avanza, e la coda ripiegata resta libera invece di
essere schiacciata dall'alluminio. Un VHB da 2,0 esiste, ma la schiuma piu' spessa assorbe meglio le
ondulazioni del vetro temperato e le dilatazioni differenziali, e quel millimetro non serve a nessun altro.
Il microfono e' il componente che quello spazio lo usa per intero: 2.5 mm su 3.0, con mezzo millimetro di
margine. E' per questo che il nastro del telaio non si assottiglia: non c'e' solo il display, dietro il vetro.
2 - IL PERCORSO DEI DUE FLAT
il telaio visto dal retro, in scala 1:1: le schede stanno entrambe sul fianco sinistro
scheda di ingresso, 43 x 43
in piedi, 4.5 di spessore
HDMI-A e USB-C girati verso
l'interno del vano
schedina terminale,
39 x 20, anche lei in piedi
flat largo: 50 mm da coprire,
ne ha 95
asola 18 x 8: ci passa solo il
flat, che e' largo 13
flat del pannello: 56 mm in linea
d'aria, ne ha 100 ma con curve
la coda ripiegata,
70 x 28
display 70 x 125
il Raspberry, e sotto di lui
il flat PCIe e il patch
Le schede stanno entrambe sul fianco sinistro,
in piedi, perche' in piano non c'e' posto: la
fascia sotto il Pi e' occupata dall'ansa del flat
PCIe e dal patch di rete, e quella sopra e' fuori
dalla portata del flat del pannello.
Il fianco destro non e' una scelta: e' quello dei
micro-HDMI del Pi, e il suo cavo angolato ha
bisogno di tutti i 17.5 mm di luce.
La schedina terminale sta cinquanta millimetri
sotto la scheda di ingresso: e' l'unico punto che
i due flat raggiungono entrambi. Spostarla piu'
in alto la mette addosso alla scheda di ingresso,
piu' in basso il flat del pannello non ci arriva.
Il flat largo e' 25 mm: fra le due schede il suo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
