Vinset85/smartofono/hardware/stl/telaio.stl

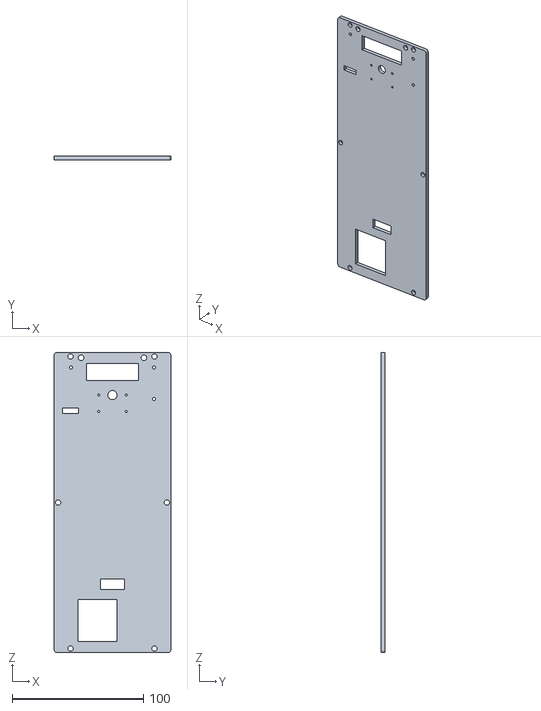
[picture p54: CAD file, 2026-10-10]
hardware/stl/telaio.stl
89.0 x 3.00 x 229.0
