Vinset85/smartofono/hardware/cad/02-telaio-portante.dxf

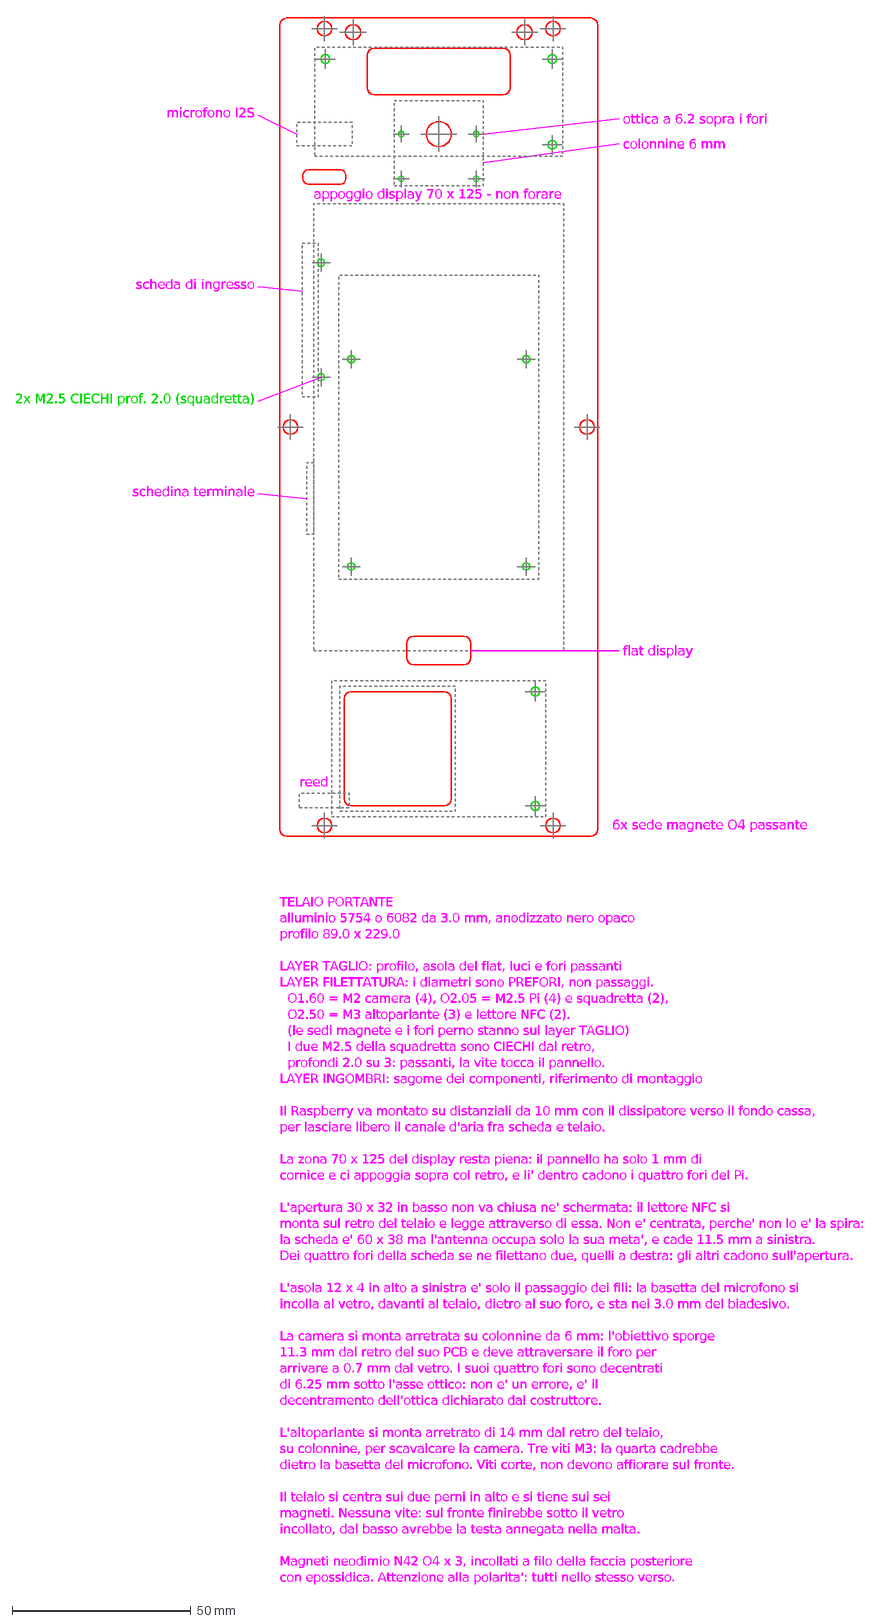
[picture p55: CAD file, 2026-10-16]
hardware/cad/02-telaio-portante.dxf
appoggio display 70 x 125 - non forare
flat display
ottica a 6.2 sopra i fori
colonnine 6 mm
microfono I2S
6x sede magnete O4 passante
reed
scheda di ingresso
schedina terminale
2x M2.5 CIECHI prof. 2.0 (squadretta)
TELAIO PORTANTE
alluminio 5754 o 6082 da 3.0 mm, anodizzato nero opaco
profilo 89.0 x 229.0
LAYER TAGLIO: profilo, asola del flat, luci e fori passanti
LAYER FILETTATURA: i diametri sono PREFORI, non passaggi.
O1.60 = M2 camera (4), O2.05 = M2.5 Pi (4) e squadretta (2),
O2.50 = M3 altoparlante (3) e lettore NFC (2).
(le sedi magnete e i fori perno stanno sul layer TAGLIO)
I due M2.5 della squadretta sono CIECHI dal retro,
profondi 2.0 su 3: passanti, la vite tocca il pannello.
LAYER INGOMBRI: sagome dei componenti, riferimento di montaggio
Il Raspberry va montato su distanziali da 10 mm con il dissipatore verso il fondo cassa,
per lasciare libero il canale d'aria fra scheda e telaio.
La zona 70 x 125 del display resta piena: il pannello ha solo 1 mm di
cornice e ci appoggia sopra col retro, e li' dentro cadono i quattro fori del Pi.
L'apertura 30 x 32 in basso non va chiusa ne' schermata: il lettore NFC si
monta sul retro del telaio e legge attraverso di essa. Non e' centrata, perche' non lo e' la spira:
la scheda e' 60 x 38 ma l'antenna occupa solo la sua meta', e cade 11.5 mm a sinistra.
Dei quattro fori della scheda se ne filettano due, quelli a destra: gli altri cadono sull'apertura.
L'asola 12 x 4 in alto a sinistra e' solo il passaggio dei fili: la basetta del microfono si
incolla al vetro, davanti al telaio, dietro al suo foro, e sta nei 3.0 mm del biadesivo.
La camera si monta arretrata su colonnine da 6 mm: l'obiettivo sporge
11.3 mm dal retro del suo PCB e deve attraversare il foro per
arrivare a 0.7 mm dal vetro. I suoi quattro fori sono decentrati
di 6.25 mm sotto l'asse ottico: non e' un errore, e' il
decentramento dell'ottica dichiarato dal costruttore.
L'altoparlante si monta arretrato di 14 mm dal retro del telaio,
su colonnine, per scavalcare la camera. Tre viti M3: la quarta cadrebbe
dietro la basetta del microfono. Viti corte, non devono affiorare sul fronte.
Il telaio si centra sui due perni in alto e si tiene sui sei
magneti. Nessuna vite: sul fronte finirebbe sotto il vetro
incollato, dal basso avrebbe la testa annegata nella malta.
Magneti neodimio N42 O4 x 3, incollati a filo della faccia posteriore
con epossidica. Attenzione alla polarita': tutti nello stesso verso.
