Vinset85/smartofono/hardware/cad/04-dima-muratura.dxf

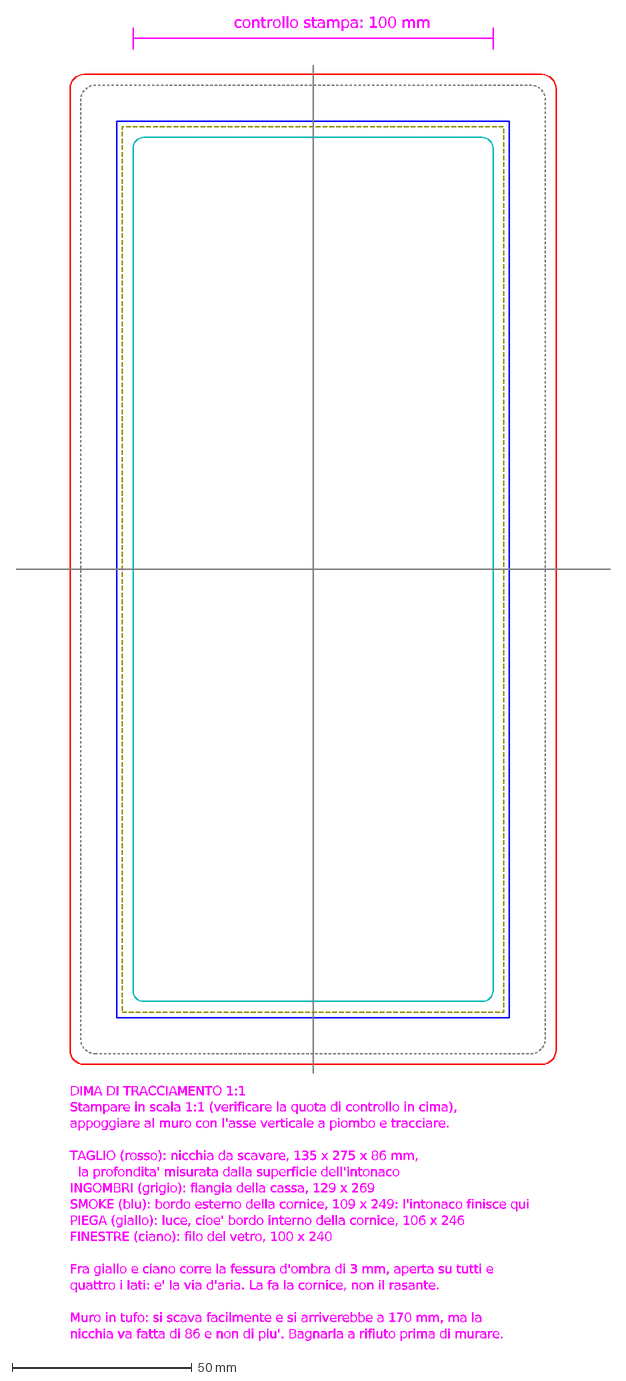
[picture p56: CAD file, 2026-10-16]
hardware/cad/04-dima-muratura.dxf
DIMA DI TRACCIAMENTO 1:1
Stampare in scala 1:1 (verificare la quota di controllo in cima),
appoggiare al muro con l'asse verticale a piombo e tracciare.
TAGLIO (rosso): nicchia da scavare, 135 x 275 x 86 mm,
la profondita' misurata dalla superficie dell'intonaco
INGOMBRI (grigio): flangia della cassa, 129 x 269
SMOKE (blu): bordo esterno della cornice, 109 x 249: l'intonaco finisce qui
PIEGA (giallo): luce, cioe' bordo interno della cornice, 106 x 246
FINESTRE (ciano): filo del vetro, 100 x 240
Fra giallo e ciano corre la fessura d'ombra di 3 mm, aperta su tutti e
quattro i lati: e' la via d'aria. La fa la cornice, non il rasante.
Muro in tufo: si scava facilmente e si arriverebbe a 170 mm, ma la
nicchia va fatta di 86 e non di piu'. Bagnarla a rifiuto prima di murare.
controllo stampa: 100 mm
