Vinset85/smartofono/hardware/cad/01-vetro-frontale.dxf

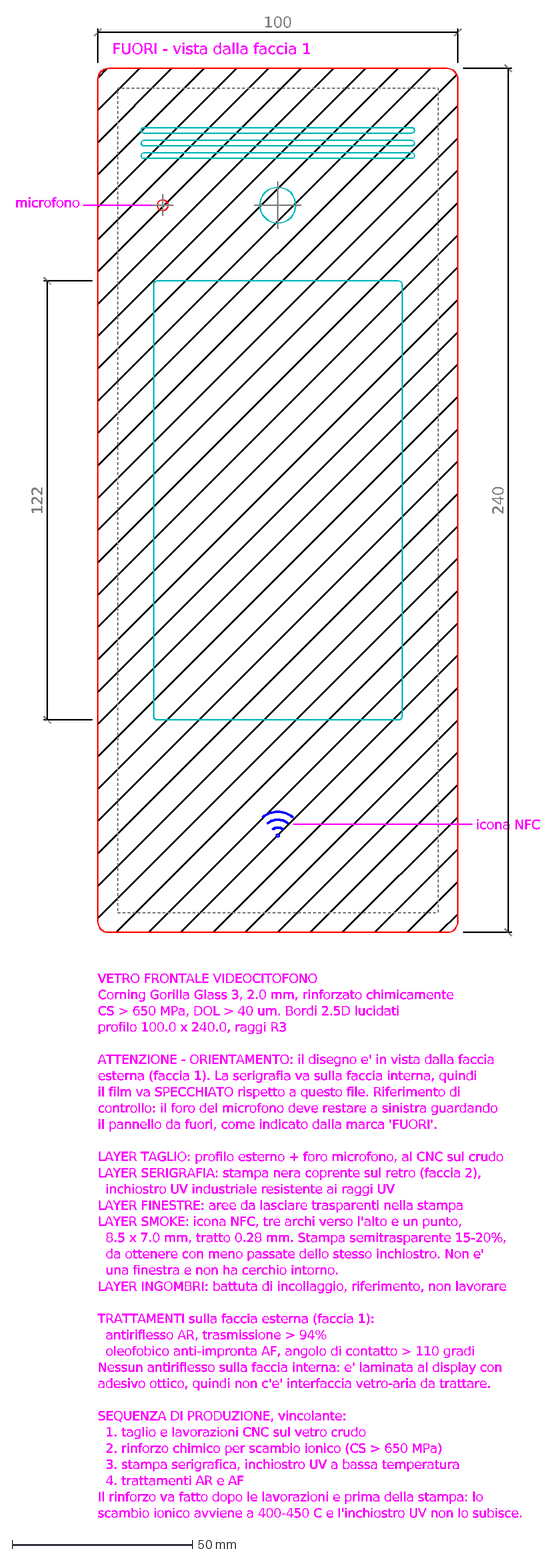
[picture p57: CAD file, 2026-10-16]
hardware/cad/01-vetro-frontale.dxf
FUORI - vista dalla faccia 1
microfono
icona NFC
100
240
122
VETRO FRONTALE VIDEOCITOFONO
Corning Gorilla Glass 3, 2.0 mm, rinforzato chimicamente
CS > 650 MPa, DOL > 40 um. Bordi 2.5D lucidati
profilo 100.0 x 240.0, raggi R3
ATTENZIONE - ORIENTAMENTO: il disegno e' in vista dalla faccia
esterna (faccia 1). La serigrafia va sulla faccia interna, quindi
il film va SPECCHIATO rispetto a questo file. Riferimento di
controllo: il foro del microfono deve restare a sinistra guardando
il pannello da fuori, come indicato dalla marca 'FUORI'.
LAYER TAGLIO: profilo esterno + foro microfono, al CNC sul crudo
LAYER SERIGRAFIA: stampa nera coprente sul retro (faccia 2),
inchiostro UV industriale resistente ai raggi UV
LAYER FINESTRE: aree da lasciare trasparenti nella stampa
LAYER SMOKE: icona NFC, tre archi verso l'alto e un punto,
8.5 x 7.0 mm, tratto 0.28 mm. Stampa semitrasparente 15-20%,
da ottenere con meno passate dello stesso inchiostro. Non e'
una finestra e non ha cerchio intorno.
LAYER INGOMBRI: battuta di incollaggio, riferimento, non lavorare
TRATTAMENTI sulla faccia esterna (faccia 1):
antiriflesso AR, trasmissione > 94%
oleofobico anti-impronta AF, angolo di contatto > 110 gradi
Nessun antiriflesso sulla faccia interna: e' laminata al display con
adesivo ottico, quindi non c'e' interfaccia vetro-aria da trattare.
SEQUENZA DI PRODUZIONE, vincolante:
1. taglio e lavorazioni CNC sul vetro crudo
2. rinforzo chimico per scambio ionico (CS > 650 MPa)
3. stampa serigrafica, inchiostro UV a bassa temperatura
4. trattamenti AR e AF
Il rinforzo va fatto dopo le lavorazioni e prima della stampa: lo
scambio ionico avviene a 400-450 C e l'inchiostro UV non lo subisce.
