Vinset85/smartofono/hardware/cad/parametri.scad

// Generato da parametri.py: non modificare a mano.

BATTUTA = 6.0;
BATTUTA_PROF = 4.0;
BIADESIVO_DISPLAY_S = 0.35;
BIADESIVO_S = 3.0;
CAMERA_ALTEZZA = 11.3;
CAMERA_ASSE_DAL_BORDO = 14.5;
CAMERA_ASSE_OFFSET = 6.25;
CAMERA_BASE_L = 10.8;
CAMERA_BASE_S = 2.75;
CAMERA_COLONNINE = 6.0;
CAMERA_CONNETTORE_S = 2.6;
CAMERA_FORI_DAL_BORDO = 2.0;
CAMERA_FORI_X = 21.0;
CAMERA_FORI_Y = 12.5;
CAMERA_FORI_Y0 = 195.75;
CAMERA_FORO_D = 1.6;
CAMERA_FORO_RISPETTO_D = 4.75;
CAMERA_FOV_DIAGONALE = 75.0;
CAMERA_GIOCO_VETRO = 0.6999999999999993;
CAMERA_LENTE_D = 5.75;
CAMERA_LENTE_FRONTALE_D = 4.0;
CAMERA_PCB_H = 23.862;
CAMERA_PCB_L = 25.0;
CAMERA_PCB_OFFSET = 2.569000000000001;
CAMERA_PCB_S = 1.12;
CAMERA_PCB_Y0 = 199.431;
CAMERA_SPORGENZA = 9.72;
CAMERA_VITE_L = 10.0;
CAMERA_X = 0.0;
CANALE_PERIMETRALE = 6.0;
CASSA_H = 234.0;
CASSA_INT_H = 231.0;
CASSA_INT_L = 91.0;
CASSA_L = 94.0;
CASSA_PARETE = 1.5;
CASSA_PROF = 75.0;
CORNICE_H = 249.0;
CORNICE_L = 109.0;
CORNICE_S = 1.5;
CORRUGATO_D = 25.0;
CORRUGATO_PASSO = 40.0;
DISPLAY_ARIA_TELAIO = 0.8499999999999999;
DISPLAY_ATTIVO_H = 120.96;
DISPLAY_ATTIVO_L = 68.04;
DISPLAY_CODA_H = 28.0;
DISPLAY_CODA_L = 70.0;
DISPLAY_CODA_RIPIEGATA = True;
DISPLAY_CODA_S = 0.5;
DISPLAY_CORNICE = 0.9799999999999969;
DISPLAY_CORNICE_X = 0.9799999999999969;
DISPLAY_CORNICE_Y = 2.020000000000003;
DISPLAY_MODULO_H = 125.0;
DISPLAY_MODULO_L = 70.0;
DISPLAY_MODULO_S = 1.8;
DISPLAY_MODULO_Y0 = 57.5;
DISPLAY_PANNELLO_S = 0.4;
DRIVER_FORI_X = 39.0;
DRIVER_FORI_Y = 39.0;
DRIVER_FORO_D = 2.5;
DRIVER_H = 43.0;
DRIVER_L = 43.0;
DRIVER_S = 4.5;
DRIVER_SPORGENZA_CONNETTORI = 0.0;
DRIVER_X = -36.0;
DRIVER_Y = 150.0;
FESSURA_ALTEZZA = 15.0;
FESSURA_ARRETRAMENTO = 8.0;
FESSURA_LARGHEZZA = 80.0;
FESSURA_LATO_L = 40.0;
FESSURA_LATO_Y0 = 192.5;
FESSURA_LATO_Y1 = 232.5;
FINESTRA_DISPLAY_H = 121.96;
FINESTRA_DISPLAY_L = 69.04;
FINESTRA_DISPLAY_Y = 59.02;
FLANGIA = 17.5;
FLANGIA_ALA = 10.0;
FLANGIA_ARRETRAMENTO = 28.0;
FLANGIA_FORI_N = 4;
FLANGIA_FORI_PASSO = 55.0;
FLANGIA_FORI_X = 59.5;
FLANGIA_FORO_D = 5.0;
FLAT_ASOLA_H = 8.0;
FLAT_ASOLA_L = 18.0;
FLAT_ASOLA_X = 0.0;
FLAT_ASOLA_Y = 57.5;
FLAT_DRIVER_L = 95.0;
FLAT_DRIVER_W = 25.0;
FLAT_PANNELLO_LUNG = 100.0;
FLAT_PANNELLO_W = 13.0;
FORO_MURO_H = 275.0;
FORO_MURO_L = 135.0;
FORO_MURO_PROF = 86.0;
GIOCO_LENTE_TELAIO = 1.25;
GOCCIOLATOIO = 2.5;
GRIGLIA_L = 76.0;
GRIGLIA_N = 3;
GRIGLIA_PASSO = 3.5;
GRIGLIA_SPESSORE = 1.5;
GRIGLIA_Y = 215.0;
HDMI_ANGOLATO_SPORGENZA = 8.0;
HDMI_A_PLUG_SPORGENZA = 20.0;
HDMI_LATO_X = 1;
HDMI_SPORGENZA = 20.0;
H_ARIA_INTERNA = 5.0;
H_VETRO_ESTERNO = 9.0;
K_TUFO = 0.3;
K_VHB = 0.1;
LUCE_INTONACO_H = 246.0;
LUCE_INTONACO_L = 106.0;
MAGNETE_D = 4.0;
MAGNETE_MARGINE = 3.0;
MAGNETE_S = 3.0;
MAGNETE_SEDE_D = 4.1;
MICROFONO_D = 3.0;
MICROFONO_X = -32.0;
MICROFONO_Y = 202.0;
MIC_APERTURA_LATO_PIN = True;
MIC_ASOLA_H = 4.0;
MIC_ASOLA_L = 12.0;
MIC_ASOLA_Y = 190.0;
MIC_INGOMBRO_S = 2.5;
MIC_PCB_H = 6.5;
MIC_PCB_L = 15.5;
MIC_PCB_S = 1.5;
NFC_ANTENNA_H = 35.0;
NFC_ANTENNA_L = 32.3;
NFC_ANTENNA_OFFSET_X = -11.5;
NFC_ANTENNA_X = -11.5;
NFC_APERTURA_H = 32.0;
NFC_APERTURA_L = 30.0;
NFC_APERTURA_X = -11.5;
NFC_DISTANZA_VETRO = 8.0;
NFC_FORI_INTERASSE_X = 54.0;
NFC_FORI_INTERASSE_Y = 32.0;
NFC_FORI_USATI_X = 1;
NFC_FORO_D = 2.5;
NFC_ICONA_APERTURA = 80.0;
NFC_ICONA_ARCHI = 3;
NFC_ICONA_H = 7.0;
NFC_ICONA_L = 8.48;
NFC_ICONA_PUNTO_D = 0.8;
NFC_ICONA_TRATTO = 0.28;
NFC_PCB_H = 38.0;
NFC_PCB_L = 60.0;
NFC_PCB_S = 5.0;
NFC_PCB_SOLO_S = 1.6;
NFC_PCB_X = 0.0;
NFC_USB_CAVO_ANGOLATO = 9.0;
NFC_USB_SPORGENZA = 2.3;
NFC_VITE_L = 6.0;
NFC_X = 0.0;
NFC_Y = 30.0;
NVME_BASE_H = 65.0;
NVME_BASE_L = 51.0;
NVME_BASE_S = 9.5;
OCA_RAPPORTO_MIN = 5.0;
OMBRA_PERIMETRALE = 3.0;
OTTICA_D = 10.0;
OTTICA_Y = 202.0;
PCIE_ANSA = 25.0;
PERNO_D = 4.0;
PERNO_FORO_D = 4.3;
PERNO_MARGINE = 8.0;
PERNO_PASSO = 48.0;
PERNO_SPORGENZA = 3.0;
PI_CONNETTORI_IN_BASSO = True;
PI_DISTANZIALI = 10.0;
PI_FORI_X = 58.0;
PI_FORI_Y = 49.0;
PI_FORO_D = 2.05;
PI_GRUPPO_H = 50.5;
PI_H = 56.0;
PI_L = 85.0;
PI_MARGINE_FORI = 3.5;
PI_PCB_S = 1.6;
PI_STACK_H = 40.5;
PI_VITE_L = 14.0;
PI_Y0 = 77.5;
POTENZA_PICCO = 11.5;
POTENZA_RIPOSO = 5.0;
REED_H = 4.0;
REED_L = 14.0;
REED_X = -32.0;
RETE_AREA_LIBERA = 0.5624999999999998;
RETE_FILO = 0.2;
RETE_H = 20.0;
RETE_L = 85.0;
RETE_LATO_L = 45.0;
RETE_MAGLIA = 0.6;
RETE_SOVRAPPOSIZIONE = 5.0;
RISCONTRO_D = 6.0;
RISCONTRO_GIOCO = 0.4;
RISCONTRO_S = 1.0;
RISCONTRO_SBORDO_MAX = 0.5;
RISCONTRO_SEDE_D = 6.4;
RISCONTRO_SEDE_PROF = 1.2;
RJ45_SPORGENZA = 34.0;
SCARICO_STAFFA_X = -40.95;
SCARICO_STAFFA_Y0 = 125.5;
SCARICO_STAFFA_Y1 = 174.5;
SERIGRAFIA_S = 0.03;
SMUSSO_SCARICO = 5.5;
SPEAKER_ARRETRAMENTO = 14.0;
SPEAKER_FLANGIA_FORO_D = 3.5;
SPEAKER_FORI_X = 63.5;
SPEAKER_FORI_Y = 24.0;
SPEAKER_FORO_D = 2.5;
SPEAKER_H = 30.5;
SPEAKER_L = 69.5;
SPEAKER_LUCE_H = 13.0;
SPEAKER_LUCE_L = 40.0;
SPEAKER_LUCE_Y = 219.5;
SPEAKER_S = 16.5;
SPEAKER_VITE_L = 18.0;
SPEAKER_X = 0.0;
SPEAKER_Y = 211.0;
STAFFA_ALA_BASE = 12.0;
STAFFA_ALA_H = 47.0;
STAFFA_FORI_CIECHI = True;
STAFFA_FORI_TELAIO_PASSO = 32.0;
STAFFA_FORO_ALA_D = 2.7;
STAFFA_FORO_PROF = 2.0;
STAFFA_FORO_SCHEDA_D = 2.7;
STAFFA_FORO_TELAIO_D = 2.05;
STAFFA_L = 47.0;
STAFFA_S = 1.5;
STAFFA_X = -39.7;
STAFFA_Z0 = 8.0;
TELAIO_H = 229.0;
TELAIO_L = 89.0;
TELAIO_S = 3.0;
TELAIO_Y0 = 5.5;
TERMINALE_H = 20.0;
TERMINALE_L = 39.0;
TERMINALE_S = 2.0;
TERMINALE_X = -36.0;
TERMINALE_Y = 100.0;
TIRAGGIO_CD = 0.6;
TUFO_DIETRO = 0.11;
VETRO_H = 240.0;
VETRO_L = 100.0;
VETRO_RAGGIO = 3.0;
VETRO_S = 2.0;
VHB_LARGHEZZA = 12.0;
Z_FLANGIA = 33.0;
Z_TELAIO = 5.0;

MAGNETI = [[-32.0, 8.5], [-32.0, 231.5], [32.0, 8.5], [32.0, 231.5], [-41.5, 120.0], [41.5, 120.0]];
RISCONTRI = [[-32.0, 7.5], [-32.0, 232.5], [32.0, 7.5], [32.0, 232.5], [-42.5, 120.0], [42.5, 120.0]];
FORI_SPEAKER = [[-31.75, 223.0], [31.75, 199.0], [31.75, 223.0]];
FORI_CAMERA = [[-10.5, 189.5], [-10.5, 202.0], [10.5, 189.5], [10.5, 202.0]];
