Vinset85/smartofono/(list of files, cad)

Other CAD files:
hardware/cad/03-cassa-incasso.dxf
