Vinset85/smartofono/installer-ha/www/placeholder.png

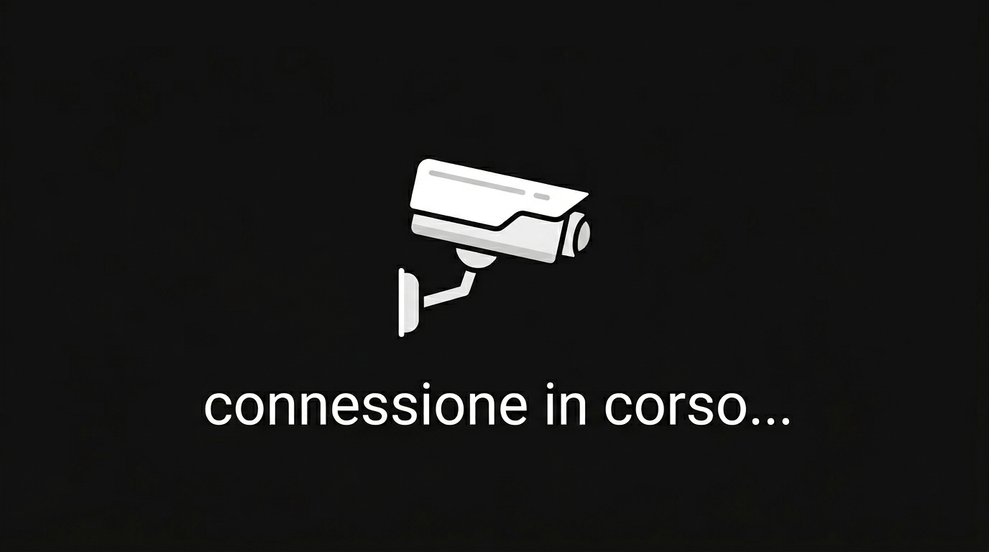
installer-ha/www/placeholder.png
