Vinset85/smartofono/installer-rpi/app/screens/pin.py

"""Schermata PIN: tastierino numerico iOS-style con verifica continua e apertura automatica della porta al primo match valido."""
from __future__ import annotations

import logging

from kivy.clock import Clock
from kivy.properties import BooleanProperty, StringProperty

from .bg_screen import BgScreen
from modules.greetings import build_greeting

LOG = logging.getLogger(__name__)


class PinScreen(BgScreen):
    pin_display = StringProperty("")
    messaggio = StringProperty("")
    errore = BooleanProperty(False)

    def __init__(self, app_ctx, bg_source: str | None = None, **kw):
        super().__init__(bg_source=bg_source, **kw)
        self.app_ctx = app_ctx
        self._pin = ""
        # Flag per impedire ulteriori inserimenti durante la transizione
        # post-success (~200ms a "result"): senza questo, un secondo tap
        # rapido potrebbe aprire una seconda volta o triggerare errori.
        self._submitting = False

    def on_pre_enter(self, *_):
        self._pin = ""
        self._submitting = False
        self._refresh()
        self.errore = False
        if self.app_ctx.pin_manager.in_lockout:
            self.errore = True
            self.messaggio = f"Bloccato per {self.app_ctx.pin_manager.lockout_remaining}s"
        else:
            self.messaggio = ""

    def _refresh(self) -> None:
        # Pallini pieni (stile iOS lock-screen): 1 cerchio per ogni cifra
        # digitata, niente placeholder vuoti. Usiamo BLACK CIRCLE U+25CF
        # (universalmente supportato da Roboto/DejaVu) invece di HEAVY
        # ASTERISK U+2731 che spesso manca nei font Linux di sistema.
        # Non-breaking space quando vuoto per preservare l'altezza riga.
        n = len(self._pin)
        self.pin_display = ("\u25CF  " * n).rstrip() if n else "\u00A0"

    def add_digit(self, d: str) -> None:
        if self._submitting:
            return
        self.app_ctx.activity_touch()
        max_len = int(self.app_ctx.config["pin"].get("lunghezza_max", 8))
        min_len = int(self.app_ctx.config["pin"].get("lunghezza_min", 4))
        if len(self._pin) >= max_len:
            return
        self._pin += d
        self._refresh()
        try:
            self.app_ctx.sound.play("key")
        except Exception:
            pass
        self.errore = False
        self.messaggio = ""
        # Auto-verifica appena raggiunta la lunghezza minima.
        # Se non c'e' match si continua a digitare (PIN piu' lungo); al
        # raggiungimento della lunghezza max si dichiara fallimento.
        if len(self._pin) < min_len:
            return
        try:
            utente = self.app_ctx.pin_manager.try_match(self._pin)
        except PermissionError as e:
            self.errore = True
            self.messaggio = str(e)
            self._pin = ""
            self._refresh()
            try:
                self.app_ctx.sound.play("error")
            except Exception:
                pass
            return
        if utente is not None:
            self._submitting = True
            self.errore = False
            self.messaggio = f"Benvenuto {utente['nome']}"
            self._apri(utente)
            return
        # Tentativo PIN ospite (scadenza/max_uses gestiti internamente)
        try:
            gp = getattr(self.app_ctx, "guest_pins", None)
            if gp is not None:
                guest = gp.try_match(self._pin)
                if guest is not None:
                    self._submitting = True
                    self.errore = False
                    label = guest.get("label") or "Ospite"
                    self.messaggio = f"Benvenuto {label}"
                    self._apri({
                        "nome": "ospite",
                        "label": label,
                        "apre": guest.get("scope", "porta"),
                        "genere": "",
                        "_guest_id": guest.get("id"),
                    })
                    return
        except Exception as e:
            LOG.debug("guest pin check err: %s", e)
        if len(self._pin) >= max_len:
            # Lunghezza max raggiunta senza match: fallimento, reset.
            self.app_ctx.pin_manager.register_failure()
            self.errore = True
            self.messaggio = "PIN errato"
            self._pin = ""
            try:
                self.app_ctx.sound.play("error")
            except Exception:
                pass
            try:
                self.app_ctx.record_event("pin_fail", method="pin",
                                          success=False)
            except Exception:
                pass
            Clock.schedule_once(lambda *_: self._refresh(), 0.4)

    def backspace(self) -> None:
        if self._submitting:
            return
        self.app_ctx.activity_touch()
        self._pin = self._pin[:-1]
        self._refresh()
        self.errore = False
        if not self.messaggio.startswith("Bloccato"):
            self.messaggio = ""
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
