Vinset85/smartofono/installer-rpi/app/modules/auto_face.py

"""Riconoscimento facciale automatico (motion-triggered).

Quando il MotionDetector rileva attivita', se la home screen e' attiva e
non c'e' una chiamata in corso, AutoFaceScanner avvia uno "scan
silenzioso" usando PicamSession (modalita' face). Se in `max_seconds`
secondi trova un volto registrato che supera il voting + liveness,
pubblica l'apertura senza richiedere il tap su "Volto".

Sicurezza: per evitare false aperture indesiderate, la modalita' e'
disattivata di default. Quando attiva, richiede:
  - liveness (blink) confermato
  - voting maggioritario su finestra
  - homepage stabile (no chiamata, no schermata speciale)

Configurazione (`face_recognition.auto_recognize`):
    enabled: false
    max_seconds: 6
    cooldown_sec: 30
    require_liveness: true
"""
from __future__ import annotations

import logging
import threading
import time
from collections import Counter, deque
from typing import Any, Callable, Optional


LOG = logging.getLogger(__name__)


class AutoFaceScanner:
    def __init__(self, app,
                 cfg: Optional[dict] = None) -> None:
        # `app` puo' essere l'istanza App (preferito) oppure un AppContext.
        # Risolve sm/face/mqtt/ha/record_open in modo difensivo.
        self.app = app
        cfg = cfg or {}
        self.enabled = bool(cfg.get("enabled", False))
        self.max_seconds = float(cfg.get("max_seconds", 6.0))
        self.cooldown_sec = float(cfg.get("cooldown_sec", 30.0))
        self.require_liveness = bool(cfg.get("require_liveness", True))
        # Bypass liveness su match ad alta confidenza (come la schermata
        # manuale): se la distanza e' molto bassa e il margine ampio, il
        # blink non viene richiesto. Coerente con FaceScreen._on_scan_result.
        self.liveness_skip_dist = float(cfg.get("liveness_skip_dist", 0.38))
        self.liveness_skip_margin = float(cfg.get("liveness_skip_margin", 0.18))
        self.vote_window = int(cfg.get("vote_window", 5))
        self.vote_required = int(cfg.get("vote_required", 3))
        self.vote_min_lead = int(cfg.get("vote_min_lead", 2))
        self.scan_hz = float(cfg.get("scan_hz", 4.0))
        # Secondi dedicati al solo ammiccamento dopo che l'identita' e' certa.
        # Servono perche' il ciclo di scansione, rallentato dal riconoscimento,
        # campiona gli occhi ~4 volte al secondo: troppo poco per cogliere un
        # battito di ciglia, che dura fra un decimo e mezzo secondo.
        self.blink_window_sec = float(cfg.get("blink_window_sec", 6.0))
        self._lock = threading.Lock()
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
