Vinset85/smartofono/(commit log)

2026-10-10 Videocitofono da incasso per Raspberry Pi 5 e Home Assistant
    Progetto completo: meccanica parametrica, disegni di produzione e software
    del pannello esterno piu' l'integrazione con Home Assistant.
    Il progetto meccanico nasce da un unico file di parametri che verifica le
    compenetrazioni fra componenti ed esce con errore se due pezzi occupano lo
    stesso volume: i sette DXF, il modello OpenSCAD e gli STL si rigenerano da
    li' e non possono divergere dalle quote.
    Nessun segreto nel repository: le credenziali stanno in secrets.yaml, di cui
    e' pubblicato solo l'esempio con le chiavi da generare, e la documentazione
    di lavoro dell'impianto reale resta fuori.
2026-10-10 Lo spessore dell'adesivo ottico lo decide la serigrafia, non l'ottica
    L'OCA e' tagliato a misura del modulo (70 x 125) mentre la finestra
    trasparente nel vetro e' 69,0 x 122,0: la laminazione scavalca il bordo
    dell'inchiostro su tutto il perimetro, mezzo millimetro sui fianchi e un
    millimetro e mezzo sopra e sotto. Su quel gradino l'adesivo deve rifluire, e
    un foglio da 0,2 mm laminato a mano non ci riesce con margine: resta un canale
    d'aria lungo il bordo della finestra, cioe' un anello di bolle dove si vede di
    piu'.
    L'adesivo passa quindi a 0,35 mm, che copre anche il caso in cui il fornitore
    stampi sei passate invece di tre. Non costa nessuna quota: il piano del telaio
    lo fissa il VHB da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
2026-10-10 LICENSE torna il testo MIT puro, l'eccezione Icons8 va in NOTICE
    Con la nota sulle icone in coda al file, GitHub classificava il progetto come
    "Other" invece di MIT: il riconoscimento automatico confronta il testo, e
    qualunque aggiunta lo rompe. L'eccezione resta scritta, in NOTICE, con anche
    il modo di liberarsene sostituendo i file.
2026-10-10 Sei difetti di produzione trovati misurando i file invece dei parametri
    Il controllo interferenze passava, ma guardava solo parametri.py. Misurando i
    DXF, gli STL e le catene di quote una per una sono venuti su sei problemi, due
    dei quali avrebbero rotto dei pezzi.
    La parete della cassa aveva tre valori diversi: 1,5 nei parametri, 2 nei
    documenti e 3 nella nota stampata sul disegno, che e' quella che arriva al
    produttore. Con 3 il vano scende a 88 x 228 e il telaio da 89 x 229 non entra,
    e la cassa non puo' crescere in fuori perche' la sua misura esterna la fissa la
    fessura d'ombra. Ora il massimo e' calcolato (2,0) e c'e' il controllo.
    Le viti del Raspberry erano M2.5 x 16: con 10 di dist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
2026-10-10 Misuro i file CAD invece di fidarmi dei parametri che li generano
    Tre difetti trovati guardando i disegni dal lato di chi li riceve.
    La griglia dell'altoparlante serigrafata sul vetro sta sul layer FINESTRE,
    cioe' vetro nudo: attraverso le strisce si vede quello che c'e' dietro. A
    quota 223 la terza finiva a 231,5, in pieno sulla fascia dei due magneti alti
    e dei due fori dei perni, che si sarebbero visti in trasparenza come quattro
    buchi neri sul fronte. Spostata a 215 le tre strisce stanno dentro la luce
    dell'altoparlante nel telaio e si affacciano sul vano, non sul metallo forato.
    Le lastre che rendono le finestre trasparenti nel modello OpenSCAD erano
    spesse mezzo decimo in piu' del ve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
2026-10-11 Quello che il fornitore riceve non diceva quello che dice il progetto
    Nove incoerenze fra i documenti d'ordine e i disegni, trovate leggendo i due
    insieme invece che uno alla volta. Le prime due avrebbero prodotto pezzi
    inservibili.
    La rete delle feritoie era disegnata 85 x 8 su una feritoia di 80 x 8: il
    margine c'era in lunghezza e non in altezza, cioe' sui due lati lunghi, che
    sono quelli che la tengono. Un ritaglio alto esattamente come la feritoia non
    ha dove incollarsi. Ora e' 85 x 13, derivata dalla feritoia piu' il bordo.
    I riscontri ferrosi, quelli che servono quando la cassa e' stampata e il
    magnete non ha ferro da attrarre, erano O8 nei documenti e O6 sul disegno, e
    sbagliavano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
2026-10-11 Cassa ventilata a filo intonaco: IP44 di progetto, non IP65
    IP65 non e' compatibile con un Pi 5 raffreddato ad aria in una cassa
    murata: la scelta e' una cassa ventilata, IP44, da installare al riparo.
    Difetti trovati e corretti:
    - foglio 03: magneti e sedi spostati di 2,5 mm (dy obsoleto)
    - la flangia attraversava le feritoie; ora sta a 33 mm dal filo
    - sezione d'aria contata lorda invece che netta della rete
    - feritoia superiore rivolta verso l'alto: sostituita da due laterali
    - silicone nella fessura in conflitto con la ventosa di estrazione
    - inclinazione incompatibile con la posa a filo: cornice in battuta
    - testi sopra le linee di taglio nei fogli 01, 02, 05, 07
    - stima termica del RE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
2026-10-11 Quote morte e OLED che restava acceso: niente lasciato al caso
    CAMERA_PCB_S veniva riassegnato da 1,12 a 1,00 dopo aver calcolato
    CAMERA_SPORGENZA: il modello 3D e il controllo delle viti usavano due
    spessori diversi. Il controllo ora segnala sia la riassegnazione sia
    la deriva.
    Nei documenti restavano la nicchia a 81, il limite del gruppo a 64,
    l'aria dietro il display a 1,0 mm e il centro a 119: erano tutti
    numeri di un progetto precedente. verifica_cad li intercetta.
    Sul pannello lo screensaver OLED restava al 20% per sempre. Dopo
    180 s spegne l'HDMI; tocco, motion e squillo lo riaccendono. Allineati
    anche i default di volume, luminosita' e il token MQTT dei comandi.
2026-10-11 Gli script di deploy chiamavano file che nel repo non ci sono
    deploy.sh si fermava su patch_lovelace_health_guest.py, assente.
    L'installer del Pi non copiava mosquitto e go2rtc in /opt, quindi
    setup-mqtt-auth dal servizio non trovava il drop-in; genera_assets
    scriveva default.png nel tree sorgente e non in /opt. Face-deps da
    root lasciava venv e data non scrivibili. Manca anche lo script
    HA per simulare il campanello, gia' previsto dalla dashboard.
2026-10-11 Health: impronta abilitata ma assente non e' "idle"
    Con fingerprint.enabled a true lo stub restava "idle" e la dashboard
    lo leggeva come lettore in ascolto. E' "down".
2026-10-11 Le foto del pannello seguono il vetro a filo e la serigrafia.
    I fotogrammi precedenti mostravano una griglia forata, un obiettivo sporgente e una cornice spessa.
2026-10-11 Le foto del pannello sono scatti sull'ingresso, non tavole da catalogo.
    Il vetro riflette il giardino e la luce del display sta sulla faccia, non su un muro vuoto.
2026-10-15 I fotogrammi seguono le quote e l'icona NFC torna al centro del vetro.
    L'apertura del telaio resta sulla spira a -11,5 mm: spostare la scheda manderebbe il connettore USB-C a filo del fianco.
2026-10-15 I fotogrammi sono fotografie della posa finita, non tavole.
    Il vetro resta a filo con la fessura da 3 mm, tre strisce, microfono a sinistra e NFC al centro.
2026-10-16 L'icona NFC sul vetro è tre archi, senza il cerchio intorno.
2026-10-17 I comandi MQTT non espongono più il token, i test girano in locale e le entità MQTT hanno un id stabile.
2026-10-18 Dopo il boot il lettore NFC entra in ascolto da solo, senza il reset USB all'avvio che lascia il chip muto.
2026-10-18 PIN, NFC e volto aprono da GPIO12 anche senza Home Assistant.
    Escono impronta e il loop USB in avvio; il kiosk attende labwc e la dashboard resta allineata all'impianto.
2026-10-18 Documenta i 12 V dell'HAT PoE per la serratura, così in blackout resta sotto UPS.
2026-10-18 Aggiunge la distinta elettronica con datasheet, link di acquisto e prezzi indicativi.
2026-10-18 Rende l'impianto 1.5.1 stabile: NFC si risveglia via UART senza staccare il touch, health e HA non allarmano a vuoto, il deploy non tocca piu rete e numpy.
2026-10-18 Ripristina lo sfondo se HA e giu al boot, segnala motion KO e chiude i buchi di deploy 1.5.2.
2026-10-18 Rinomina gli entity_id HA via websocket, perche il file registry viene sovrascritto al riavvio.
2026-10-18 Chiude l'issuer LiveKit con secret, spegne il keep-alive go2rtc e tiene il kiosk in vita.
2026-10-19 Porta l'anteprima Lovelace su go2rtc MSE e tiene l'NFC in ascolto senza falsi muti.
    Il WebRTC nel tab di HA rimontava la dashboard; lo stream HTTP in card no. Il PN532 andava in sleep a ogni close nfcpy e il ping UART corto lo dichiarava muto.
